0hasant/Liion_Cell_Simulator/docs/SCHEMATIC_REVIEW.md

# Schematic review (closed in v0.4)

The v0.3 checklist asked you to mark every item OK / CHANGE / ?. It was still empty when the hardware had to be finished, so the items were decided in v0.4. The decision for each ID (P-01 … F-02) is in `docs/CHANGES_v0.4.md`, section 2.

If you disagree with a decision, write the ID and what you want here and commit. `hardware/tools/design.py` holds the whole circuit, so most changes are one or two lines there.

| ID | Your comment |
|---|---|
| | |

What still has to be checked is no longer on paper but on the bench: `docs/BRINGUP.md`.

The part list with pin-to-net connections is `hardware/kicad/` (netlist) and `hardware/bom.csv`.
