0hasant/Liion_Cell_Simulator/docs/PROJECT_SYNC.md

# PROJECT_SYNC: shared context for all chats and sessions

Read this first in any new chat about the Li-ion cell test bench. It is where the hardware chat and the 3D/mechanical chat agree on what we are building and what the limits are.

- Repo: `0hasant/Liion_Cell_Simulator`.
- **Master copy: `docs/PROJECT_SYNC.md` in the repo.** The Claude Project "Li-ion cell characteristic tester" holds a mirror. Edit the repo file, commit, then update the Project copy with the same text.

Last updated: 2026-11-11 (repo state v0.4: hardware design complete, not yet built)

## 1. Goal

Build a single-cell Li-ion characterization bench so that, in the end, we can fit a **2RC equivalent-circuit model** of a cell (OCV, R0, R1/C1, R2/C2 versus SOC and temperature).

Order of work: (1) hardware and mechanics (**design done in v0.4**), (2) build and bring-up, (3) firmware + Python UI, (4) test procedures and model fitting.

This is part of the Solaris final-year project (see the DAB converter project).

- **Budget:** about 5,500 TL at 2026-11-10 prices (`hardware/bom.csv` + `hardware/bom_offboard.csv`). The old 1500 TL target cannot be met.
- **Workshop:** hand soldering, FDM printing (PETG/ASA, 220 × 220 mm bed), PCB milling on the Snapmaker Artisan / Artisan Premium.

## 2. What the bench does (requirements)

- **Cells:** 18650 and 21700, one at a time (DMEGC INR45E, generic 3.5 Ah 18650).
- **Discharge:** 0 to 10 A linear constant-current load, down to 2.0 V.
- **Charge:** from a 30 V bench PSU through an XL4016 module. Voltage set by MCU PWM below a 4.25 V hardware ceiling (module trimmer); **hardware current limit** 0–5.6 A set by MCU PWM.
  - Up to 5 A for the 21700 (INR45E).
  - The generic 3.5 Ah 18650 is limited to about 0.5C (≈1.75 A) until its datasheet is known.
- **Measurement:** bidirectional current on one 10 mΩ 2512 shunt with Kelvin taps, Kelvin cell voltage, both on one ADS1115. Four NTCs on the Blue Pill ADC. Fast current and voltage on the Blue Pill ADC for R0.
- **Temperature control:** cell held at about 10 to 45 °C in an insulated pocket, 2 × TEC1-12706, polarity relay for heat/cool.
- **Control:** STM32F103 Blue Pill, USB CDC to a Python UI.
- **Safety:** hardware OV / UV / OC / OT protection, latched, that drops a safety relay (removes power from all relay coils and the Peltier) without firmware. Power-up state is tripped.

## 3. Who owns what

| Area | Chat | Source of truth |
|---|---|---|
| Electronics (schematic, PCB, BOM, protection, parts choice) | Hardware chat | `hardware/` (generated by `hardware/tools/`) |
| Enclosure, thermal unit, cell pocket, printed parts | 3D / mechanical chat | `mechanical/` |
| Firmware, Python UI, test procedures, model fitting | Not started | `firmware/`, `ui/` |

Rule: a chat edits only its own area. If it needs something from the other area, it writes a request in section 7 instead of changing the other side.

## 4. Interface contract (the numbers both sides must respect)

### Hardware gives mechanics

| Item | Value | Source |
|---|---|---|
| PCB size | 180 × 130 mm, **single-sided** FR4 1.6 mm, milled in-house | `hardware/kicad/cell_test_bench.kicad_pcb` |
| Board model for fitting | `hardware/kicad/cell_test_bench.step` | `kicad-cli pcb export step` (see `mechanical/README.md`) |
| Mounting holes | 4 × M3 at (4, 4), (176, 68), (4, 126), (176, 126) mm from the PCB top-left corner. PCB on 8 mm standoffs. | `hardware/tools/pcbgen.py` |
| Connector placement | **Left:** PSU in J101, 12 V buck J102, charger J401, FB tap J402. **Top:** thermostat J104, fans J704/J706/J705, Peltier J702, Blue Pill USB (x ≈ 166). **Right:** NTCs J501–J504. **Bottom:** cell J205 (x 40), load resistor J301 (x 84), Q301 (x 108–119), Kelvin J206 (x 130). | `pcbgen.py` FIXED table |
| Load MOSFET | IRFP260N (TO-247), Q301 body centre at PCB x = 113.45, tab 0.6 mm inside the bottom edge, facing out | `pcbgen.py` |
| Plug-in modules | Blue Pill (USB end at top edge), ADS1115 (body over PCB x 152–169, y 68–96) | Dwgs.User layer |
| Heat sources | Q301 + 0.1 Ω 50 W resistor on the load cooler (up to about 40 W), XL4016 modules, 7805 (small) | |
| Thermostat | KSD9700 60 °C NC on the load cooler, wired to J104 (in series with the safety relay coil) | Power sheet |
| Fans | Two 12 V cooler fans switched together on one PWM (PA8): load cooler and Peltier hot-side cooler. One 12 V 30 mm pocket mixing fan, always on. | Thermal sheet |
| Peltier | Two TEC1-12706 in series on J702 (2 wires, about 3 A). No driver module in the thermal unit. | Thermal sheet |
| NTCs (4, on PA2–PA5) | Cell surface (taped to the cell), pocket air (lid port), load cooler, Peltier hot side | Measurement sheet |

### Mechanics gives hardware

| Item | Value |
|---|---|
| Electronics box | 214 × 214 × 89 mm outer (86 mm base + 3 mm lid) |
| Load cooler | 80 × 80 × 54 mm CPU cooler on its side, base flush with the PCB bottom edge, centred on Q301, fan facing the front wall |
| Thermal unit | 130 × 130 × about 155 mm outer (base 72.8 mm + 8 mm feet, pocket body 56 mm, lid 18 mm) |
| Cell pocket | 100 × 50 × 6 mm aluminium cold plate is the pocket floor. Saddles T6 (18650) / T7 (21700). Contact plates 22 × 22 × 1.5 mm copper with a spring probe for Kelvin sense. |
| Cable links between units | Grommet 1 (right wall, y 95): cell power 2 × 1.5 mm² + Kelvin pair. Grommet 2 (right wall, y 175): Peltier 2 × 0.75 mm², two fan pairs, three NTC pairs. |

## 5. Hard constraints (do not break without agreeing)

1. One cell at a time, 18650 or 21700, swapped by changing the printed saddle.
2. Pocket temperature range about 10 to 45 °C. Printed parts near the cell and the load cooler must be PETG or ASA, not PLA.
3. Every printed part fits a 220 × 220 mm bed (`mechanical/check.py` checks it).
4. Max currents:
   - Discharge: 10 A (trip about 11.6 A).
   - Charge: 5 A (hardware limit 5.6 A, trip about 6.2 A); generic 18650 about 1.75 A.
   - Wiring, contacts and the shunt path must carry this. No wire jumpers in the cell loop.
5. Cell voltage limits enforced in hardware: OV about 4.33 V, UV about 1.96 V. OT trip about 61 °C on the heatsink or cell NTC. Charger ceiling 4.25 V.
6. Cell terminals need four-wire (Kelvin) contact.
7. Hand-solderable parts: through-hole, plus R201 (2512) and U301 (SOIC-8) on the copper side.
8. PCB design rules for milling: 0.5 mm track, 0.4 mm clearance, copper ≥ 1 mm from the edge, annular ring ≥ 0.4 mm.
9. Every part must be buyable in Türkiye (`hardware/tools/sourcing.py` holds shop, price, stock and link).
10. The KiCad files are generated. Once someone edits them by hand in KiCad, those files become the source of truth: don't re-run the generators after that.

## 6. Known limits and risks (carry these forward)

- **Not built yet.** All circuit numbers are calculated, not measured. Follow `docs/BRINGUP.md`.
- **Wire jumpers:** a single copper layer needs several wire jumpers on the component side (`hardware/fab/jumpers.csv`).
- **Milled copper is thin:** reinforce the cell loop and PGND strip with 1.5 mm² wire (`docs/CNC_MILLING.md`).
- **Voltage trips are ground-referenced:** at 5 A charge OV acts near 4.28 V, at 10 A discharge UV near 2.06 V.
- **UV trips with no cell** and blocks arming without a cell (intended).
- **ADS1115 divider** draws 0.2 mA from a cell left in the pocket with the bench off.
- **Check before soldering:** ADS1115 module pin order, HK14FD relay pinout, SRD relay contact pins, real cooler base flatness.
- **Load loop stability** depends on layout: scope the current step at bring-up (C304).
- **3D envelopes:** cooler, XL4016 and resistor shapes are envelopes. Measure real parts and update `mechanical/enclosure.py`.
- **Lowest cell temperature:** depends on the hot-side cooler; measure before relying on below-ambient tests.
- **Prices and stock:** checked on one day (2026-11-10). A few generic items are estimates.

## 7. Open interface items (requests between chats)

Add one line per item: `date | from -> to | request | status`.

- 2026-10-28 | sync review -> hardware + mechanics | Peltier driver location. | **Superseded 2026-11-10:** BTS7960 removed in v0.4. Peltiers driven from the main board (K3 polarity relay + IRLZ44N), two wires to the thermal unit.
- 2026-11-10 | hardware -> mechanics | v0.4 board: heatsinks are 80 × 80 × 54 mm CPU coolers, no MP1584, no BTS7960, connectors moved (section 4). | **Done 2026-11-11** in `mechanical/enclosure.py` v0.4.

## 8. Change protocol

1. Before changing any number in section 4 or 5, edit this file in the same commit and add a line to the changelog.
2. If hardware moves a connector, heatsink position, or mounting hole, the PCB STEP must be regenerated and the mechanical side told via section 7.
3. If mechanics changes box size, standoff height, or cable path, the hardware side is told via section 7.
4. Start of every chat: read this file, then `README.md` (and `mechanical/README.md` for 3D work).
   - PCB work: `docs/LAYOUT_REVIEW.md` (checklist), `docs/CNC_MILLING.md`.
   - Schematic work: `docs/SCHEMATIC_GUIDE.md`, `docs/CHANGES_v0.4.md`.
5. After editing this file in the repo, copy the same text to the Claude Project (`claude/PROJECT_SYNC.md`).

## 9. Changelog

- 2026-10-28: file created from repo state v0.2 when hardware and 3D design were split into separate chats.
- 2026-10-28: review fixes; layout moved to Quilter; BTS7960 location decided (option a).
- 2026-10-29 (v0.3.2): layout paused for a schematic review. Added `docs/SCHEMATIC_GUIDE.md` and `docs/SCHEMATIC_REVIEW.md`.
- 2026-11-11 (v0.4): hardware design finished.
  - Schematic v0.4: parts replaced by ones in stock in Türkiye; review items closed (`docs/CHANGES_v0.4.md`). MCP4725 ×2, second ADS1115, BTS7960, MP1584 removed; hardware charge-current limit, fault latch and safety relay added; PGND/GND split.
  - Single-sided PCB routed in-house (`hardware/tools/route2.py`), because Quilter can't make single-sided boards. CNC files in `hardware/fab/`.
  - Priced BOM with Turkish shops.
  - Enclosure v0.4: CPU coolers, cooler cradle, taller thermal base, cold-plate clamp, grommets moved.
  - New docs: `CHANGES_v0.4.md`, `BRINGUP.md`, `CNC_MILLING.md`.
