0hasant/Liion_Cell_Simulator/hardware/fab/drill_summary.csv

Hole mm | Count | Use
0.8 | 266 | IC, header, small diode, transistor
1.0 | 212 | resistors, caps, wire jumpers
1.3 | 25 | terminals, TO-220/247, relays
1.5 | 47 | relay power pins, TO-247
1.8 | 6 | terminal blocks
2.0 | 4 | large pins
3.2 | 4 | M3 mounting holes
