0hasant/Liion_Cell_Simulator/hardware/fab/jumpers.csv

Wire | Footprint | Net | From pad | x1 mm | y1 mm | To pad | x2 mm | y2 mm | Length mm | Wire type
W1 | W1 | +12V | 1 | 29.4 | 18.2 | 2 | 29.4 | 44.6 | 26.4 | 0.75 mm2 stranded (power)
W2 | W2 | +12V | 1 | 33.5 | 17.4 | 2 | 55.4 | 7.0 | 24.2 | 0.75 mm2 stranded (power)
W3 | W3 | +12V | 1 | 64.5 | 9.5 | 2 | 82.2 | 37.1 | 32.8 | 0.75 mm2 stranded (power)
W4 | W4 | +12V | 1 | 70.0 | 6.5 | 2 | 77.4 | 7.0 | 7.4 | 0.75 mm2 stranded (power)
W5 | W5 | +12V | 1 | 86.2 | 37.4 | 2 | 85.5 | 53.2 | 15.8 | 0.75 mm2 stranded (power)
W6a | W6 | +12VA | 1 | 103.0 | 72.8 | 2 | 98.6 | 63.7 | 10.1 | 0.6 mm solid, insulated
W6b | W6 | +12VA | 2 | 98.6 | 63.7 | 3 | 85.3 | 63.6 | 13.3 | 0.6 mm solid, insulated
W6c | W6 | +12VA | 1 | 103.0 | 72.8 | 4 | 118.3 | 89.8 | 22.9 | 0.6 mm solid, insulated
W7 | W7 | +12V_SW | 1 | 62.8 | 48.0 | 2 | 78.2 | 26.3 | 26.6 | 0.75 mm2 stranded (power)
W8 | W8 | +12V_SW | 1 | 68.2 | 18.8 | 2 | 54.8 | 18.8 | 13.4 | 0.75 mm2 stranded (power)
W9 | W9 | +12V_SW | 1 | 78.7 | 22.5 | 2 | 70.6 | 18.2 | 9.2 | 0.75 mm2 stranded (power)
W10 | W10 | +3V3 | 1 | 135.3 | 67.1 | 2 | 124.8 | 68.3 | 10.6 | 0.6 mm solid, insulated
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
