0hasant/Liion_Cell_Simulator/docs/pcb_v0.4_copper_mirrored.png

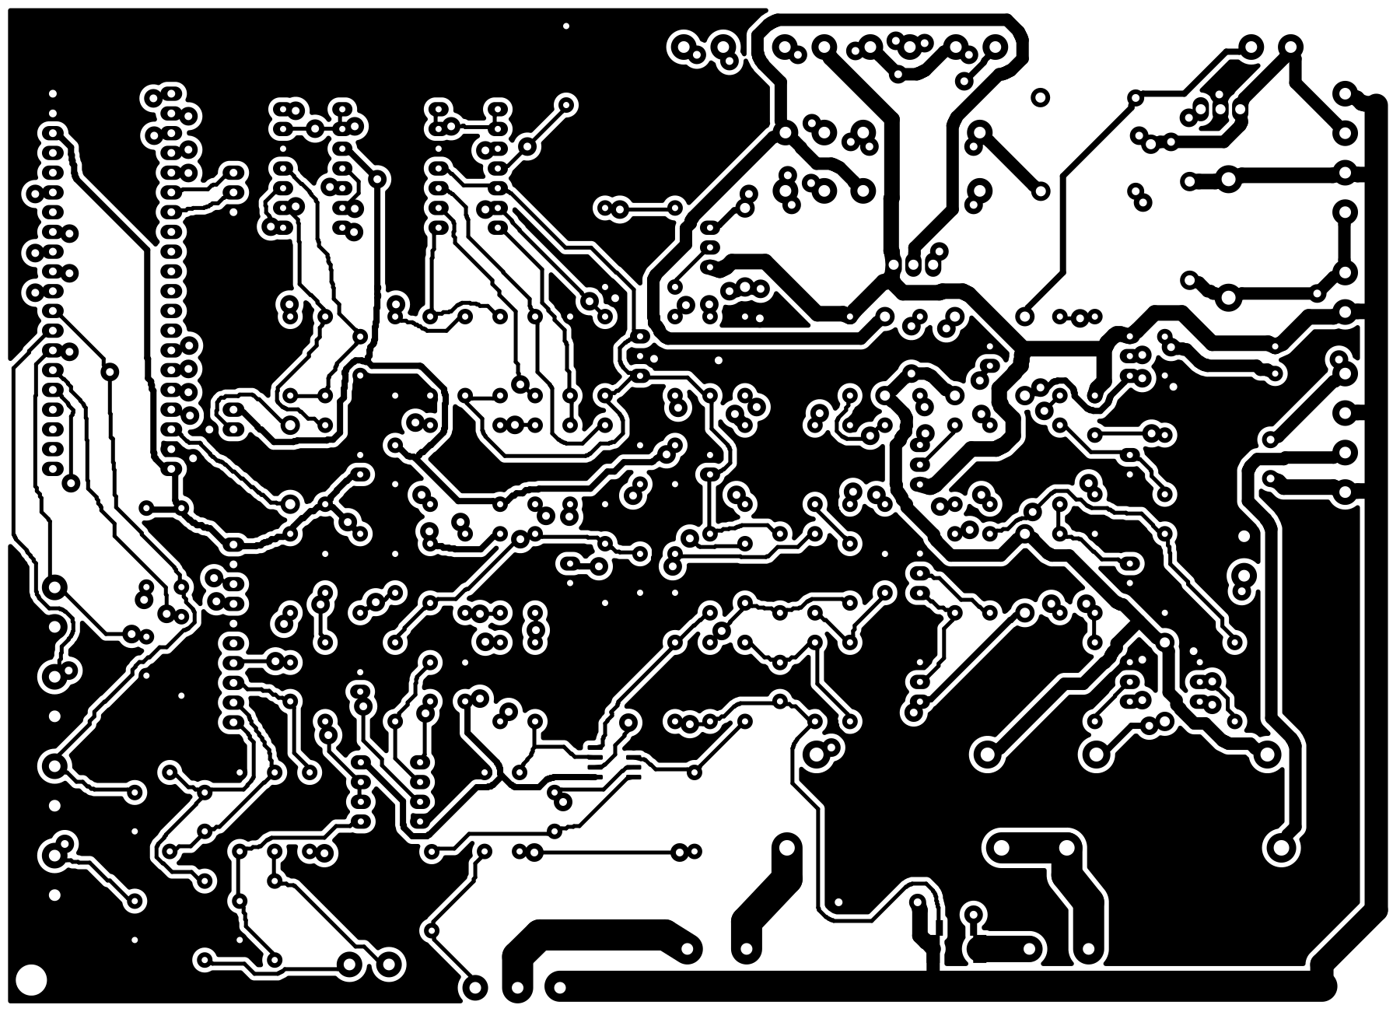
docs/pcb_v0.4_copper_mirrored.png
