0hasant/Liion_Cell_Simulator/docs/pcb_v0.4_layout.png

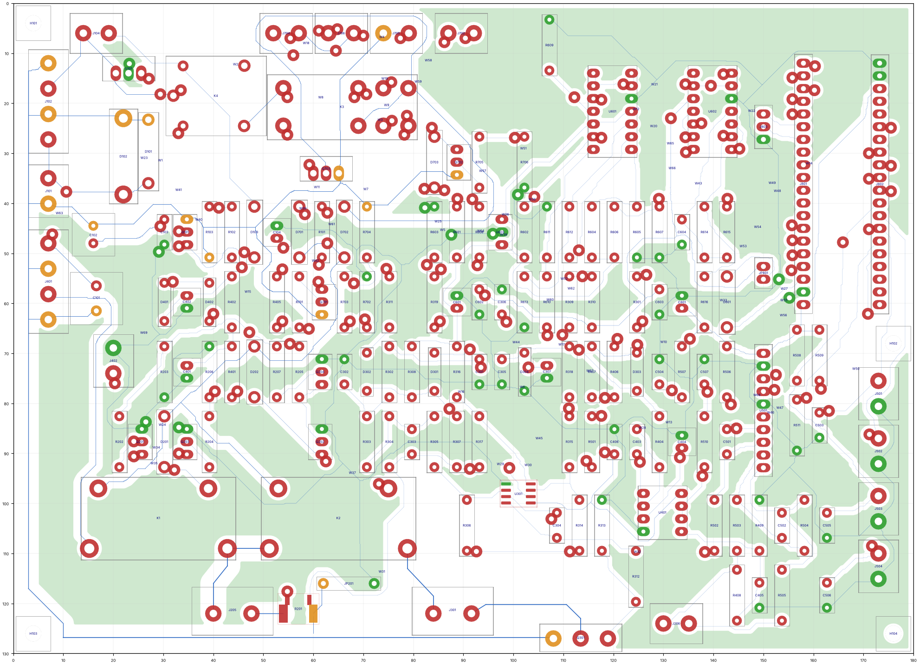
docs/pcb_v0.4_layout.png
