0hasant/Liion_Cell_Simulator/mechanical/renders/electronics_box.png

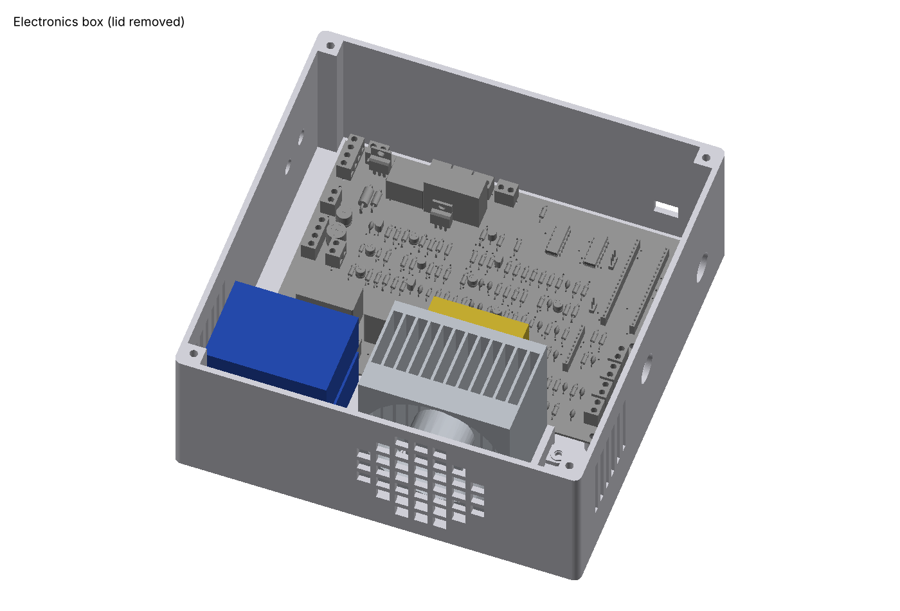
mechanical/renders/electronics_box.png
