0hasant/Liion_Cell_Simulator/mechanical/renders/thermal_pocket_detail.png

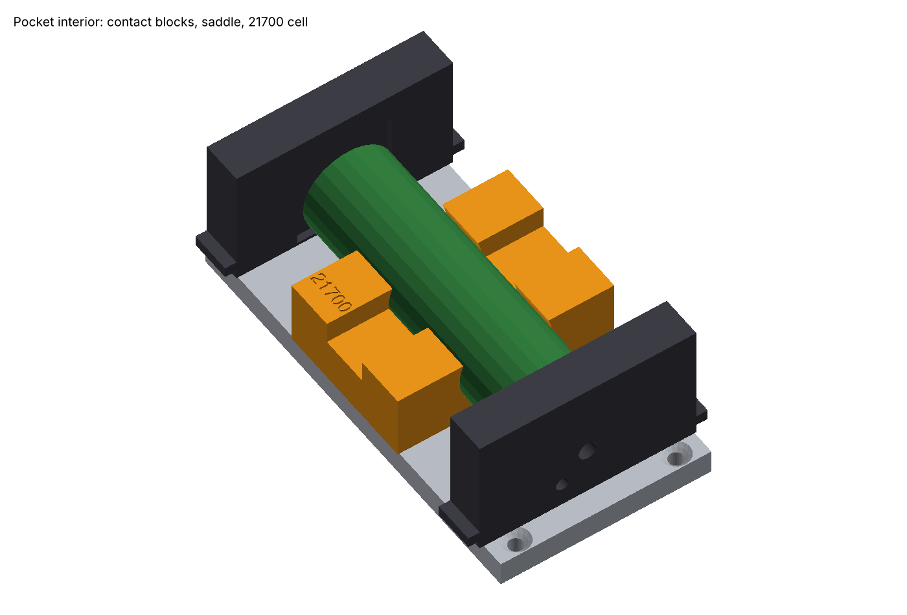
mechanical/renders/thermal_pocket_detail.png
