0hasant/Liion_Cell_Simulator/mechanical/renders/thermal_unit.png

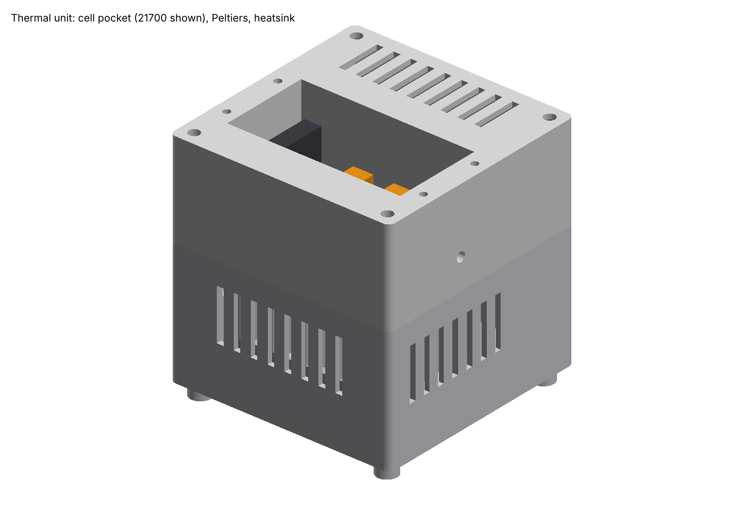
mechanical/renders/thermal_unit.png
