0hasant/Liion_Cell_Simulator/hardware/bom.csv

Qty | References | Value | Footprint | Buy | Shop | Unit TL (VAT incl.) | Line TL | Stock 2026-11-10 | Link | Note
1 | C101 | 100uF 50V | CP_Radial_D10.0mm_P5.00mm | electrolytic 100 uF 50 V, D10 P5 | Direnc.net | 4.00 | 4.00 | generic, price estimated
1 | C102 | 220uF 25V | CP_Radial_D8.0mm_P3.50mm | electrolytic 220 uF 25 V, D8 P3.5 | Direnc.net | 3.00 | 3.00 | generic, price estimated
13 | C103 C303 C306 C403 C406 C501 C502 C503 C504 C505 C506 C602 C603 | 100nF | C_Disc_D5.0mm_W2.5mm_P5.00mm | ceramic capacitor, radial, 5 mm pitch, 50 V | Direnc.net | 0.98 | 12.74 | in stock (100 nF checked) | https://www.direnc.net/100nf-63v-seramik | 1 nF / 10 nF / 1 uF: same series, price similar
7 | C104 C307 C401 C402 C404 C601 C801 | 10uF 25V | CP_Radial_D5.0mm_P2.50mm | electrolytic 10 uF 25 V (or 50 V), D5 P2.5 | Direnc.net | 1.50 | 10.50 | generic, price estimated
2 | C301 C302 | 1uF | C_Disc_D5.0mm_W2.5mm_P5.00mm | ceramic capacitor, radial, 5 mm pitch, 50 V | Direnc.net | 0.98 | 1.96 | in stock (100 nF checked) | https://www.direnc.net/100nf-63v-seramik | 1 nF / 10 nF / 1 uF: same series, price similar
1 | C304 | 1nF | C_Disc_D5.0mm_W2.5mm_P5.00mm | ceramic capacitor, radial, 5 mm pitch, 50 V | Direnc.net | 0.98 | 0.98 | in stock (100 nF checked) | https://www.direnc.net/100nf-63v-seramik | 1 nF / 10 nF / 1 uF: same series, price similar
4 | C305 C405 C507 C604 | 10nF | C_Disc_D5.0mm_W2.5mm_P5.00mm | ceramic capacitor, radial, 5 mm pitch, 50 V | Direnc.net | 0.98 | 3.92 | in stock (100 nF checked) | https://www.direnc.net/100nf-63v-seramik | 1 nF / 10 nF / 1 uF: same series, price similar
1 | D101 | P6KE39CA (TVS) | D_DO-15_P12.70mm_Horizontal | P6KE39CA TVS 600 W DO-15 | Direnc.net | 12.79 | 12.79 | in stock | https://www.direnc.net/p6ke39ca-do-15-371v-600w-tvs-diyot
1 | D102 | 1N5408 | D_DO-201AD_P15.24mm_Horizontal | 1N5408 3 A DO-201 | Direnc.net | 2.72 | 2.72 | in stock | https://www.direnc.net/1n5408-rectifiers-1000v-3a--mic
7 | D103 D201 D202 D701 D702 D703 D801 | 1N5819 | D_DO-41_SOD81_P10.16mm_Horizontal | 1N5819 Schottky 1 A 40 V DO-41 | Direnc.net | 1.57 | 10.99 | in stock | https://www.direnc.net/1n5819-1a-40v-schottky-rectifier-mic | 1N4007 was sold out, 1N5819 does the same job here
2 | D301 D302 | 1N4148 | D_DO-35_SOD27_P7.62mm_Horizontal | 1N4148 DO-35 | Robotistan | 0.79 | 1.58 | in stock | https://www.robotistan.com/1n4148-100v-450ma-aksiyel-tipli-hizli-diyot | sold out at Direnc
4 | D303 D304 D401 D402 | BAT85 | D_DO-35_SOD27_P7.62mm_Horizontal | BAT85 Schottky DO-35 | Direnc.net | 2.03 | 8.12 | in stock | https://www.direnc.net/bat85-schottky-diodes-rectifiers-schottky-30v-200ma
2 | J101 J702 | PSU in 30V (+, -) via inline 5A fuse | TerminalBlock_bornier-2_P5.08mm | 2-pin 5.08 mm screw terminal ("1 No") | Direnc.net | 4.84 | 9.68 | in stock | https://www.direnc.net/1-numara-2li-klemens
2 | J102 J401 | 12V buck XL4016: IN+ IN- OUT+ OUT- | TerminalBlock_bornier-4_P5.08mm | 4-pin 5.08 mm screw terminal (two 2-pin blocks slid together) | Direnc.net | 9.68 | 19.36 | in stock | https://www.direnc.net/1-numara-2li-klemens
10 | J104 J206 J402 J501 J502 J503 J504 J704 J706 J705 | Thermostat 60C NC (on load heatsink) | TerminalBlock_bornier-2_P5.08mm | 2-pin 5.08 mm screw terminal ("0 No") | Direnc.net | 3.45 | 34.50 | in stock | https://www.direnc.net/0-numara-2li-klemens-1 | sensor, fan, thermostat and FB wires
2 | J205 J301 | Cell power to pocket (+, -) via inline 15A fuse | PhoenixContact_GMSTBVA_2,5_2-G-7,62_1x02_P7.62mm_Vertical | 2-pin 7.62 mm pluggable terminal, header 180 deg + plug | Direnc.net | 13.21 | 26.42 | in stock | https://www.direnc.net/2-pin-762mm-90-gecmeli-takim-klemens-12424 | plug: https://www.direnc.net/2-pin-762mm-90-gecmeli-takim-klemens
2 | J801 J802 | Blue Pill header A: B12 B13 B14 B15 A8 A9 A10 A11 A12 A15 B3 B4 B5 B6 B7 B8 B9 5V GND 3V3 | PinSocket_1x20_P2.54mm_Vertical | 1x40 precision (machined) female header 2.54 mm, cut to 1x20 | Direnc.net | 21.17 | 42.34 | in stock | https://www.direnc.net/1x40-precision-disi-header | the plain 1x40 female header (6.05 TL) was sold out; cutting a machined strip costs one pin
1 | J803 | Debug UART: TX RX GND | PinHeader_1x03_P2.54mm_Vertical | 1x40 male pin header 2.54 mm (cut) | Direnc.net | 5.00 | 5.00 | generic, price estimated
1 | JP201 | GND-PGND link (wire) | WireLink_P10.16mm | wire link (resistor leg or 0.8 mm copper wire) | - | 0.00 | 0.00 | -
1 | JP801 | Board 5V to Blue Pill (normally open) | PinHeader_1x02_P2.54mm_Vertical | 1x40 male pin header 2.54 mm (cut) | Direnc.net | 5.00 | 5.00 | generic, price estimated
2 | K1 K2 | ALFG2PF121 (charge) | Relay_SPST_Panasonic_ALFG_FormA_CircularHoles | Panasonic ALFG2PF121, 12 V, 33 A | Ozdisan | 148.90 | 297.80 | 28609 in stock | https://ozdisan.com/elektromekanik-komponentler/roleler-ve-role-soketleri/genel-tip-roleler/ALFG2PF121/462930 | USD 2.64 + VAT
1 | K3 | HK14FD-DC12V-SHG (DPDT, polarity) | Relay_DPDT_Finder_40.52 | Huike HK14FD-DC12V-SHG, DPDT 5 A, 12 V ("4052" type) | Direnc.net | 72.59 | 72.59 | in stock | https://www.direnc.net/12v-cift-kontak-huike-4052-12v-10a | alternative: Tianbo TRA3-L-12VDC-S-2Z (116 TL)
1 | K4 | SRD-12VDC-SL-C (safety) | Relay_SPDT_SANYOU_SRD_Series_Form_C | Songle SRD-12VDC-SL-C, 10 A | Robotistan | 20.68 | 20.68 | in stock | https://www.robotistan.com/12v-10a-tek-kontak-role-srd12vdcslc
5 | Q101 Q201 Q202 Q701 Q702 | BC337 | TO-92_Inline_Wide | BC337 NPN TO-92 | Direnc.net | 1.21 | 6.05 | in stock | https://www.direnc.net/bc337-transistor-bjt-npn-to-92
2 | Q203 Q204 | BC547 | TO-92_Inline_Wide | BC547 NPN TO-92 | Direnc.net | 1.28 | 2.56 | in stock | https://www.direnc.net/bc547-transistor-bjt-npn-to-92
1 | Q301 | IRFP260N | TO-247-3_Vertical | IRFP260NPBF TO-247 | Ozdisan | 43.43 | 43.43 | 4451 in stock | https://www.ozdisan.com/en/p/discrete-mosfets-435/infineon-irfp260npbf-3517 | USD 0.77 + VAT; Direnc lists IRFP260M at 69.87 TL (sold out on the check date)
1 | Q703 | IRLZ44N | TO-220-3_Vertical | IRLZ44NPBF TO-220 (VBsemi) | Robotistan | 24.46 | 24.46 | in stock | https://www.robotistan.com/vbsemi-elec-irlz44npbf-vb | TO-220 was sold out at Direnc
2 | R101 R102 | 2.2k | R_Axial_DIN0207_L6.3mm_D2.5mm_P10.16mm_Horizontal | 1/4 W 1 % metal film resistor (E24 value) | Direnc.net | 0.67 | 1.34 | in stock (series) | https://www.direnc.net/14w-metal-film-direnc | check each value in the cart; all values used are E24
1 | R103 | 4.7k | R_Axial_DIN0207_L6.3mm_D2.5mm_P10.16mm_Horizontal | 1/4 W 1 % metal film resistor (E24 value) | Direnc.net | 0.67 | 0.67 | in stock (series) | https://www.direnc.net/14w-metal-film-direnc | check each value in the cart; all values used are E24
1 | R201 | 10mR 1% 2.5W 2512 | R_Shunt_2512_Kelvin | Isabellenhuette CMS 10 mOhm 1 % 2.5 W, 2512 | Direnc.net | 39.63 | 39.63 | in stock | https://www.direnc.net/10mr-2515-sont-direnc | listed as "10mR 2515"; datasheet says size 2512
8 | R202 R205 R304 R314 R317 R318 R601 R701 | 1k | R_Axial_DIN0207_L6.3mm_D2.5mm_P10.16mm_Horizontal | 1/4 W 1 % metal film resistor (E24 value) | Direnc.net | 0.67 | 5.36 | in stock (series) | https://www.direnc.net/14w-metal-film-direnc | check each value in the cart; all values used are E24
29 | R203 R204 R206 R207 R301 R302 R305 R306 R307 R310 R313 R406 R408 R503 R504 R506 R507 R508 R509 R510 R511 R602 R603 R605 R615 R616 R702 R704 R706 | 10k | R_Axial_DIN0207_L6.3mm_D2.5mm_P10.16mm_Horizontal | 1/4 W 1 % metal film resistor (E24 value) | Direnc.net | 0.67 | 19.43 | in stock (series) | https://www.direnc.net/14w-metal-film-direnc | check each value in the cart; all values used are E24
1 | R303 | 6.8k | R_Axial_DIN0207_L6.3mm_D2.5mm_P10.16mm_Horizontal | 1/4 W 1 % metal film resistor (E24 value) | Direnc.net | 0.67 | 0.67 | in stock (series) | https://www.direnc.net/14w-metal-film-direnc | check each value in the cart; all values used are E24
1 | R308 | 10M | R_Axial_DIN0207_L6.3mm_D2.5mm_P10.16mm_Horizontal | 1/4 W 1 % metal film resistor (E24 value) | Direnc.net | 0.67 | 0.67 | in stock (series) | https://www.direnc.net/14w-metal-film-direnc | check each value in the cart; all values used are E24
3 | R309 R613 R614 | 100k | R_Axial_DIN0207_L6.3mm_D2.5mm_P10.16mm_Horizontal | 1/4 W 1 % metal film resistor (E24 value) | Direnc.net | 0.67 | 2.01 | in stock (series) | https://www.direnc.net/14w-metal-film-direnc | check each value in the cart; all values used are E24
1 | R311 | 150k | R_Axial_DIN0207_L6.3mm_D2.5mm_P10.16mm_Horizontal | 1/4 W 1 % metal film resistor (E24 value) | Direnc.net | 0.67 | 0.67 | in stock (series) | https://www.direnc.net/14w-metal-film-direnc | check each value in the cart; all values used are E24
6 | R312 R319 R501 R502 R505 R703 | 100R | R_Axial_DIN0207_L6.3mm_D2.5mm_P10.16mm_Horizontal | 1/4 W 1 % metal film resistor (E24 value) | Direnc.net | 0.67 | 4.02 | in stock (series) | https://www.direnc.net/14w-metal-film-direnc | check each value in the cart; all values used are E24
1 | R315 | 12k | R_Axial_DIN0207_L6.3mm_D2.5mm_P10.16mm_Horizontal | 1/4 W 1 % metal film resistor (E24 value) | Direnc.net | 0.67 | 0.67 | in stock (series) | https://www.direnc.net/14w-metal-film-direnc | check each value in the cart; all values used are E24
1 | R316 | 18k | R_Axial_DIN0207_L6.3mm_D2.5mm_P10.16mm_Horizontal | 1/4 W 1 % metal film resistor (E24 value) | Direnc.net | 0.67 | 0.67 | in stock (series) | https://www.direnc.net/14w-metal-film-direnc | check each value in the cart; all values used are E24
2 | R401 R402 | 560R | R_Axial_DIN0207_L6.3mm_D2.5mm_P10.16mm_Horizontal | 1/4 W 1 % metal film resistor (E24 value) | Direnc.net | 0.67 | 1.34 | in stock (series) | https://www.direnc.net/14w-metal-film-direnc | check each value in the cart; all values used are E24
2 | R404 R609 | 15k | R_Axial_DIN0207_L6.3mm_D2.5mm_P10.16mm_Horizontal | 1/4 W 1 % metal film resistor (E24 value) | Direnc.net | 0.67 | 1.34 | in stock (series) | https://www.direnc.net/14w-metal-film-direnc | check each value in the cart; all values used are E24
1 | R405 | 3.3k | R_Axial_DIN0207_L6.3mm_D2.5mm_P10.16mm_Horizontal | 1/4 W 1 % metal film resistor (E24 value) | Direnc.net | 0.67 | 0.67 | in stock (series) | https://www.direnc.net/14w-metal-film-direnc | check each value in the cart; all values used are E24
1 | R407 | 22k | R_Axial_DIN0207_L6.3mm_D2.5mm_P10.16mm_Horizontal | 1/4 W 1 % metal film resistor (E24 value) | Direnc.net | 0.67 | 0.67 | in stock (series) | https://www.direnc.net/14w-metal-film-direnc | check each value in the cart; all values used are E24
1 | R409 | 1M | R_Axial_DIN0207_L6.3mm_D2.5mm_P10.16mm_Horizontal | 1/4 W 1 % metal film resistor (E24 value) | Direnc.net | 0.67 | 0.67 | in stock (series) | https://www.direnc.net/14w-metal-film-direnc | check each value in the cart; all values used are E24
2 | R604 R611 | 16k | R_Axial_DIN0207_L6.3mm_D2.5mm_P10.16mm_Horizontal | 1/4 W 1 % metal film resistor (E24 value) | Direnc.net | 0.67 | 1.34 | in stock (series) | https://www.direnc.net/14w-metal-film-direnc | check each value in the cart; all values used are E24
1 | R606 | 27k | R_Axial_DIN0207_L6.3mm_D2.5mm_P10.16mm_Horizontal | 1/4 W 1 % metal film resistor (E24 value) | Direnc.net | 0.67 | 0.67 | in stock (series) | https://www.direnc.net/14w-metal-film-direnc | check each value in the cart; all values used are E24
2 | R607 R610 | 9.1k | R_Axial_DIN0207_L6.3mm_D2.5mm_P10.16mm_Horizontal | 1/4 W 1 % metal film resistor (E24 value) | Direnc.net | 0.67 | 1.34 | in stock (series) | https://www.direnc.net/14w-metal-film-direnc | check each value in the cart; all values used are E24
1 | R608 | 11k | R_Axial_DIN0207_L6.3mm_D2.5mm_P10.16mm_Horizontal | 1/4 W 1 % metal film resistor (E24 value) | Direnc.net | 0.67 | 0.67 | in stock (series) | https://www.direnc.net/14w-metal-film-direnc | check each value in the cart; all values used are E24
1 | R612 | 24k | R_Axial_DIN0207_L6.3mm_D2.5mm_P10.16mm_Horizontal | 1/4 W 1 % metal film resistor (E24 value) | Direnc.net | 0.67 | 0.67 | in stock (series) | https://www.direnc.net/14w-metal-film-direnc | check each value in the cart; all values used are E24
1 | R705 | 470R | R_Axial_DIN0207_L6.3mm_D2.5mm_P10.16mm_Horizontal | 1/4 W 1 % metal film resistor (E24 value) | Direnc.net | 0.67 | 0.67 | in stock (series) | https://www.direnc.net/14w-metal-film-direnc | check each value in the cart; all values used are E24
1 | U101 | L7805CV | TO-220-3_Vertical | L7805CV TO-220 | Direnc.net | 8.72 | 8.72 | in stock | https://www.direnc.net/l7805cv-5v-15a-lineer-voltaj-regulator-to220
1 | U301 | OPA2171AIDR | SOIC-8_3.9x4.9mm_P1.27mm | OPA2171AIDR SOIC-8 | Direnc.net | 93.76 | 93.76 | in stock | https://www.direnc.net/opa2171aidr-smd-10396 | replaces OPA2188 (no stock in Turkiye)
1 | U401 | LM358P | DIP-8_W7.62mm | LM358P DIP-8 | Direnc.net | 4.23 | 4.23 | in stock | https://www.direnc.net/arama?q=LM358P
1 | U501 | ADS1115 module (ADDR=GND): VDD GND SCL SDA ADDR ALRT A0 A1 A2 A3 | PinSocket_1x10_P2.54mm_Vertical | ADS1115 16-bit I2C module + socket strip | Direnc.net | 145.18 | 145.18 | in stock | https://www.direnc.net/ads1115-16-bit-i2c-4-kanal-modul | pin order must be VDD GND SCL SDA ADDR ALRT A0 A1 A2 A3
2 | U601 U602 | LM339N | DIP-14_W7.62mm | LM339N DIP-14 | Direnc.net | 6.05 | 12.10 | in stock | https://www.direnc.net/lm339n-pdip-14-dip-komparator-entegresi
1 | U603 | TL431 (TO-92) | TO-92_Inline_Wide | TL431G-T92-B, TO-92 | Direnc.net | 3.51 | 3.51 | in stock | https://www.direnc.net/tl431g-t92-b-to92-voltaj-referans-entegresi
 |  |  |  | PCB parts total |  |  | 1036.53
