0hasant/Liion_Cell_Simulator/mechanical/step/cell_test_bench_assembly.step

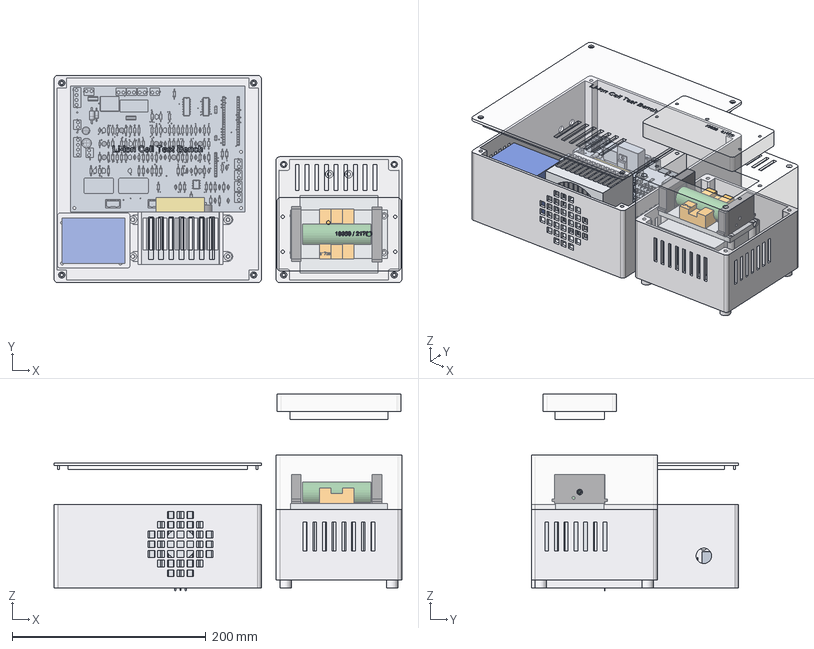
[picture p6: CAD file, 2026-11-10]
mechanical/step/cell_test_bench_assembly.step
359.0 x 214.0 x 203.0 mm
E1_ebox_base
E2_ebox_lid
PCB
E4_cooler_cradle
load_cooler_80x80x54
series_R_0R1_50W
KSD9700_60C
E3_module_plate
XL4016_charger
XL4016_12V
T1_thermal_base
hot_side_cooler_80x80x54
TEC1_12706_1
TEC1_12706_2
cold_plate_alu
T2_pocket_body
T3_pocket_lid
thermal_pad
T4_contact_block_fixed
T5_contact_block_slider
T7_saddle_21700
cell_21700
