0hasant/Liion_Cell_Simulator/hardware/kicad/cell_test_bench.step

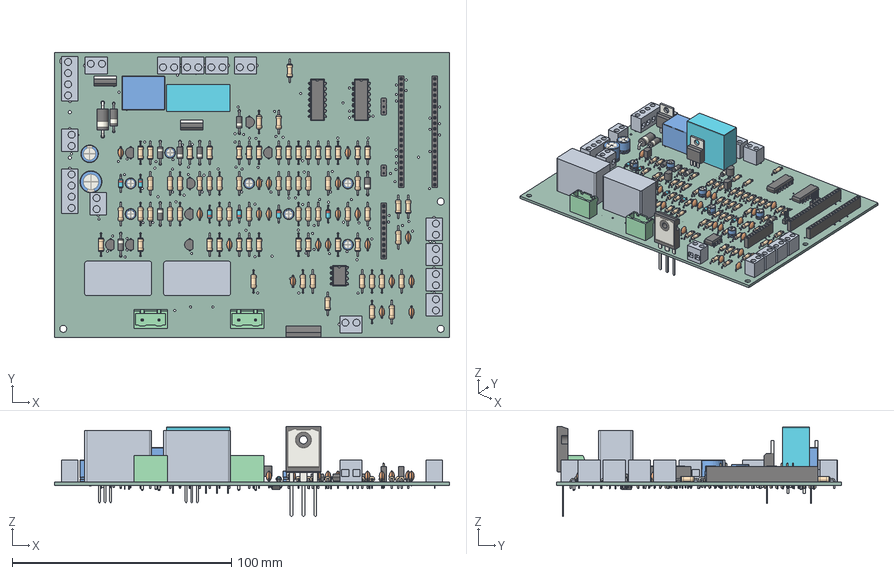
[picture p7: CAD file, 2026-11-10]
hardware/kicad/cell_test_bench.step
180.0 x 130.0 x 41.1 mm
TO-92_Inline_Wide x 8
R_Axial_DIN0207_L63mm_D25mm_P1016mm_Horizontal x 69
D_DO-201AD_P15.24mm_Horizontal
C_Disc_D50mm_W25mm_P500mm x 20
Relay_SPDT_SANYOU_SRD_Series_Form_C
D_DO-41_SOD81_P10.16mm_Horizontal x 7
TO-220-3_Vertical x 2
D_DO-35_SOD27_P7.62mm_Horizontal x 6
PinSocket_1x20_P254mm_Vertical x 2
PinHeader_1x03_P254mm_Vertical
D_DO-15_P12.70mm_Horizontal
Relay_DPDT_Finder_40.52
DIP-14_W7.62mm x 2
CP_Radial_D80mm_P350mm
TO-247-3_Vertical
GMSTBVA_01x02_G_7_62mm x 2
CP_Radial_D50mm_P250mm x 7
PinHeader_1x02_P254mm_Vertical
PinSocket_1x10_P254mm_Vertical
CP_Radial_D100mm_P500mm
DIP-8_W7.62mm
SOIC_8_39x49mm_P127mm
cell_test_bench PCB
