0hasant/Liion_Cell_Simulator/mechanical/stl/T3_pocket_lid.stl

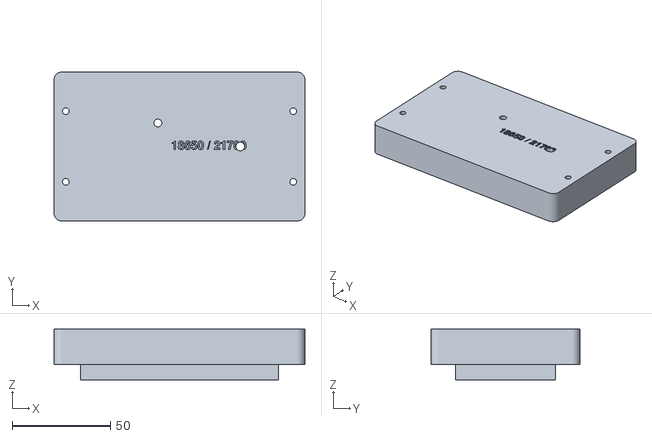
[picture p8: CAD file, 2026-11-10]
mechanical/stl/T3_pocket_lid.stl
128.0 x 76.0 x 26.0
