0hasant/Liion_Cell_Simulator/mechanical/stl/T1_thermal_base.stl

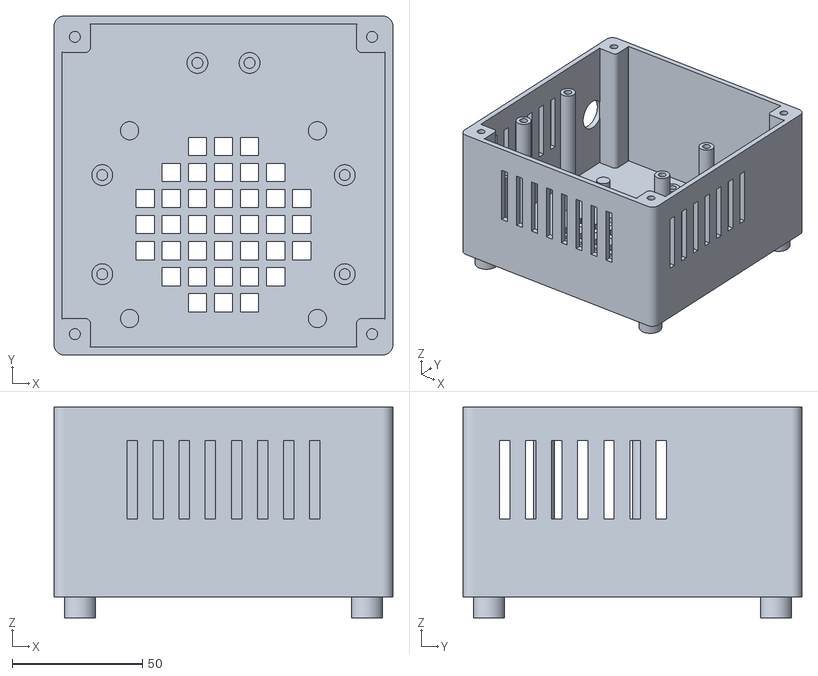
[picture p9: CAD file, 2026-11-10]
mechanical/stl/T1_thermal_base.stl
130.0 x 130.0 x 80.8
