0hasant/Liion_Cell_Simulator/mechanical/stl/E2_ebox_lid.stl

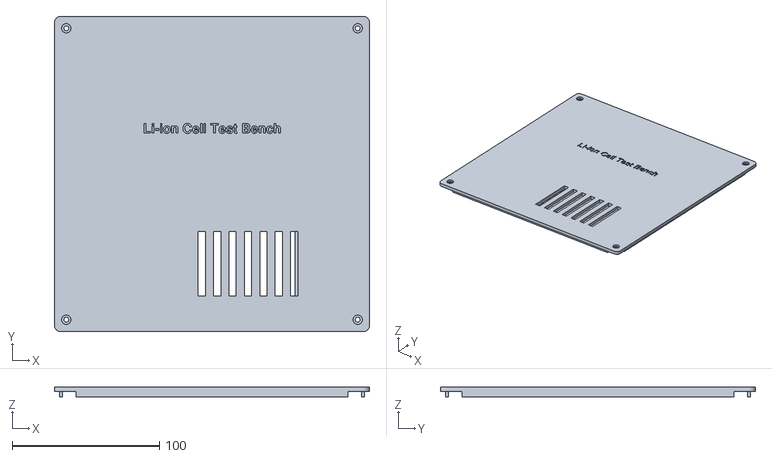
[picture p10: CAD file, 2026-11-10]
mechanical/stl/E2_ebox_lid.stl
214.0 x 214.0 x 7.00
