0hasant/Liion_Cell_Simulator/mechanical/stl/T2_pocket_body.stl

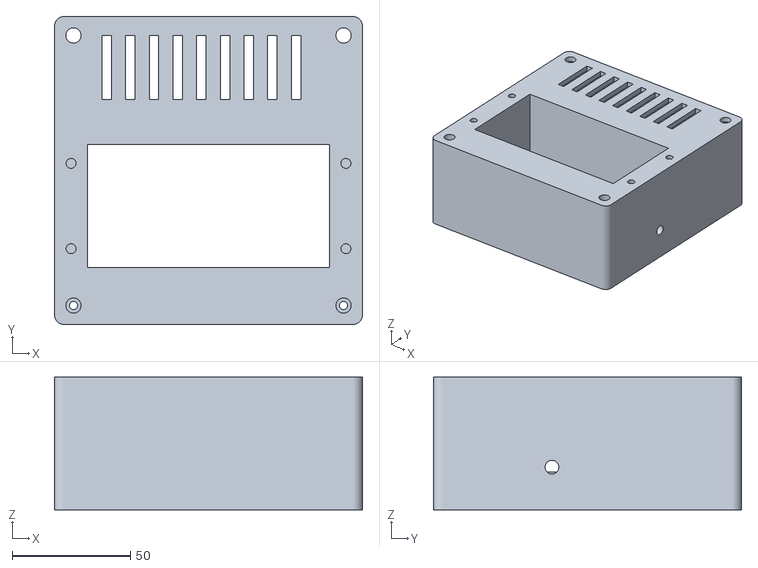
[picture p11: CAD file, 2026-11-10]
mechanical/stl/T2_pocket_body.stl
130.0 x 130.0 x 56.0
