0hasant/Liion_Cell_Simulator/mechanical/stl/E1_ebox_base.stl

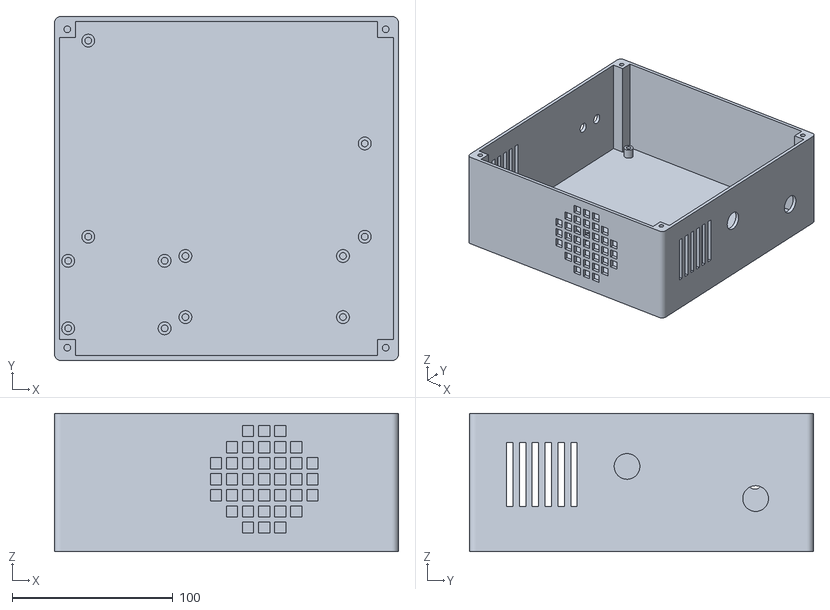
[picture p12: CAD file, 2026-11-10]
mechanical/stl/E1_ebox_base.stl
214.0 x 214.0 x 86.0
