0hasant/Liion_Cell_Simulator/mechanical/stl/E4_cooler_cradle.stl

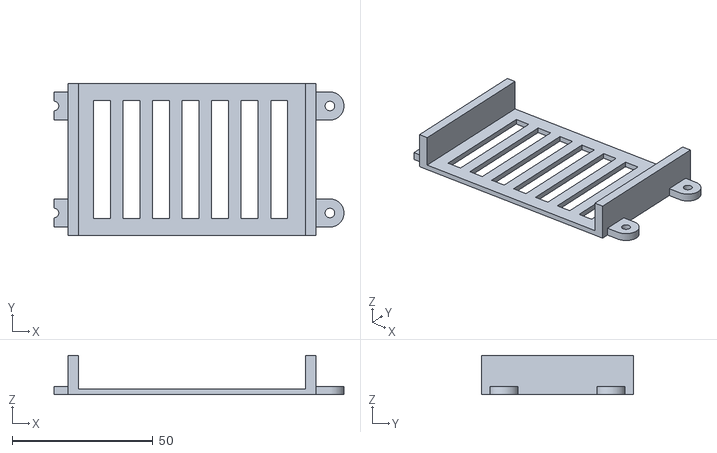
[picture p13: CAD file, 2026-11-10]
mechanical/stl/E4_cooler_cradle.stl
103.0 x 54.0 x 14.0
