0hasant/Liion_Cell_Simulator/mechanical/stl/T6_saddle_18650.stl

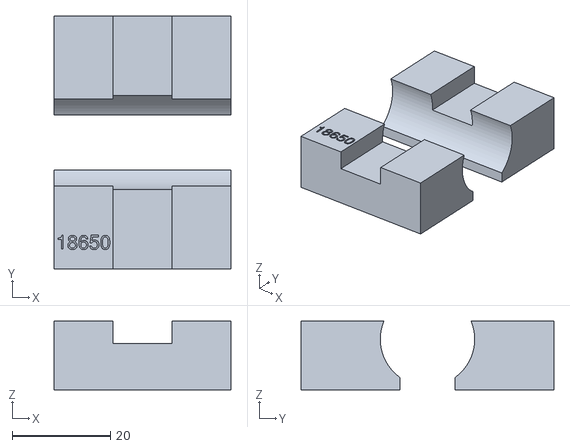
[picture p14: CAD file, 2026-10-27]
mechanical/stl/T6_saddle_18650.stl
36.0 x 51.4 x 13.9
