0hasant/Liion_Cell_Simulator/mechanical/stl/E3_module_plate.stl

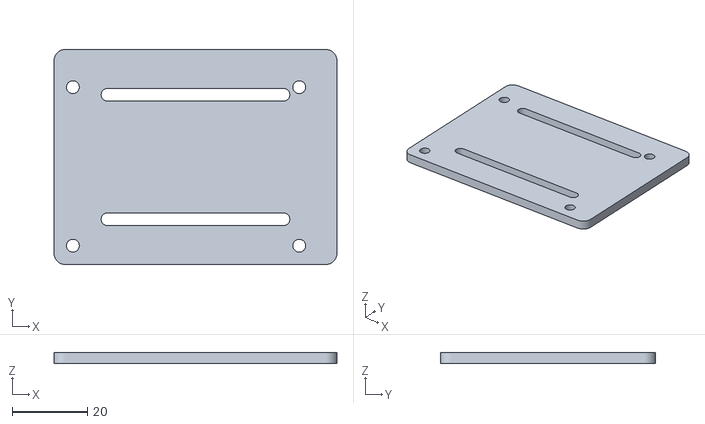
[picture p15: CAD file, 2026-10-27]
mechanical/stl/E3_module_plate.stl
75.0 x 57.0 x 3.00
