0hasant/Liion_Cell_Simulator/mechanical/stl/T5_contact_block_slider.stl

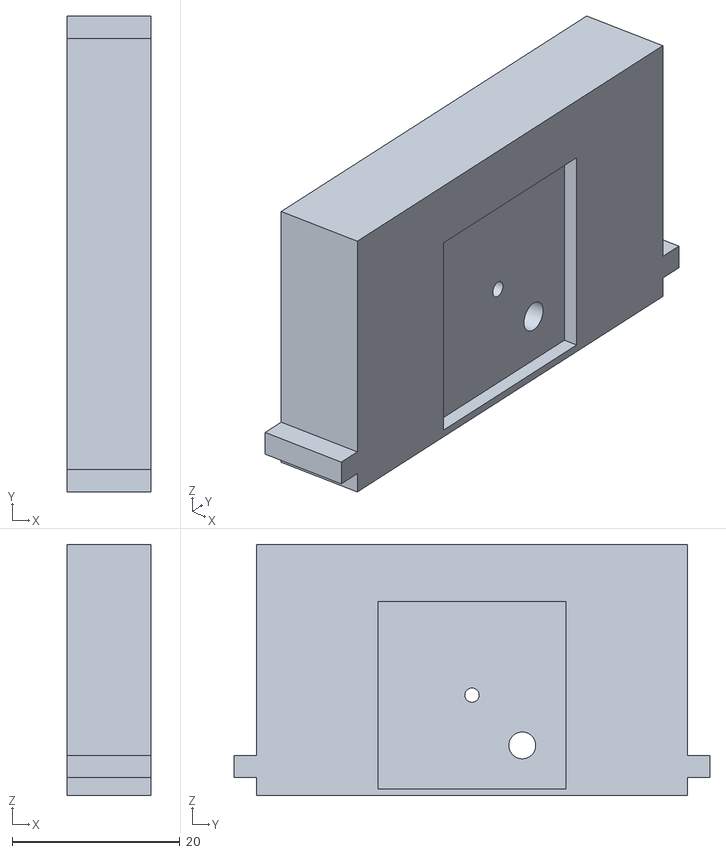
[picture p16: CAD file, 2026-10-27]
mechanical/stl/T5_contact_block_slider.stl
10.0 x 56.8 x 30.0
