0hasant/Liion_Cell_Simulator/mechanical/stl/T7_saddle_21700.stl

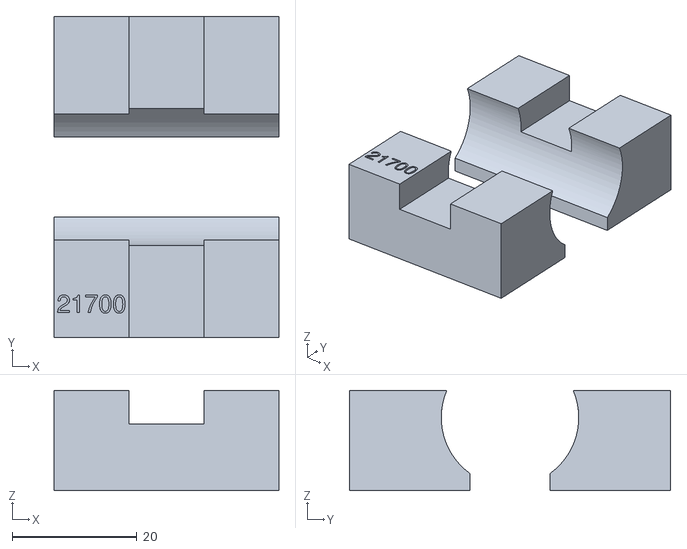
[picture p17: CAD file, 2026-10-27]
mechanical/stl/T7_saddle_21700.stl
36.0 x 51.4 x 16.0
