0hasant/Liion_Cell_Simulator/(list of files, cad)

Other CAD files:
mechanical/stl/T4_contact_block_fixed.stl
