0hasant/Liion_Cell_Simulator/mechanical/renders/assembly_exploded.png

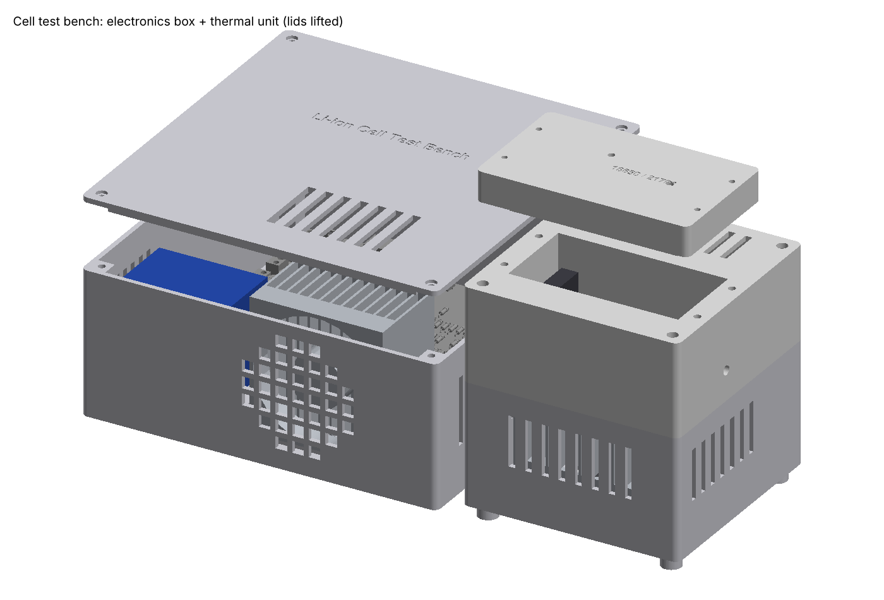
mechanical/renders/assembly_exploded.png
