0hasant/Liion_Cell_Simulator/hardware/fab/print/assembly_component_side_1to1.pdf

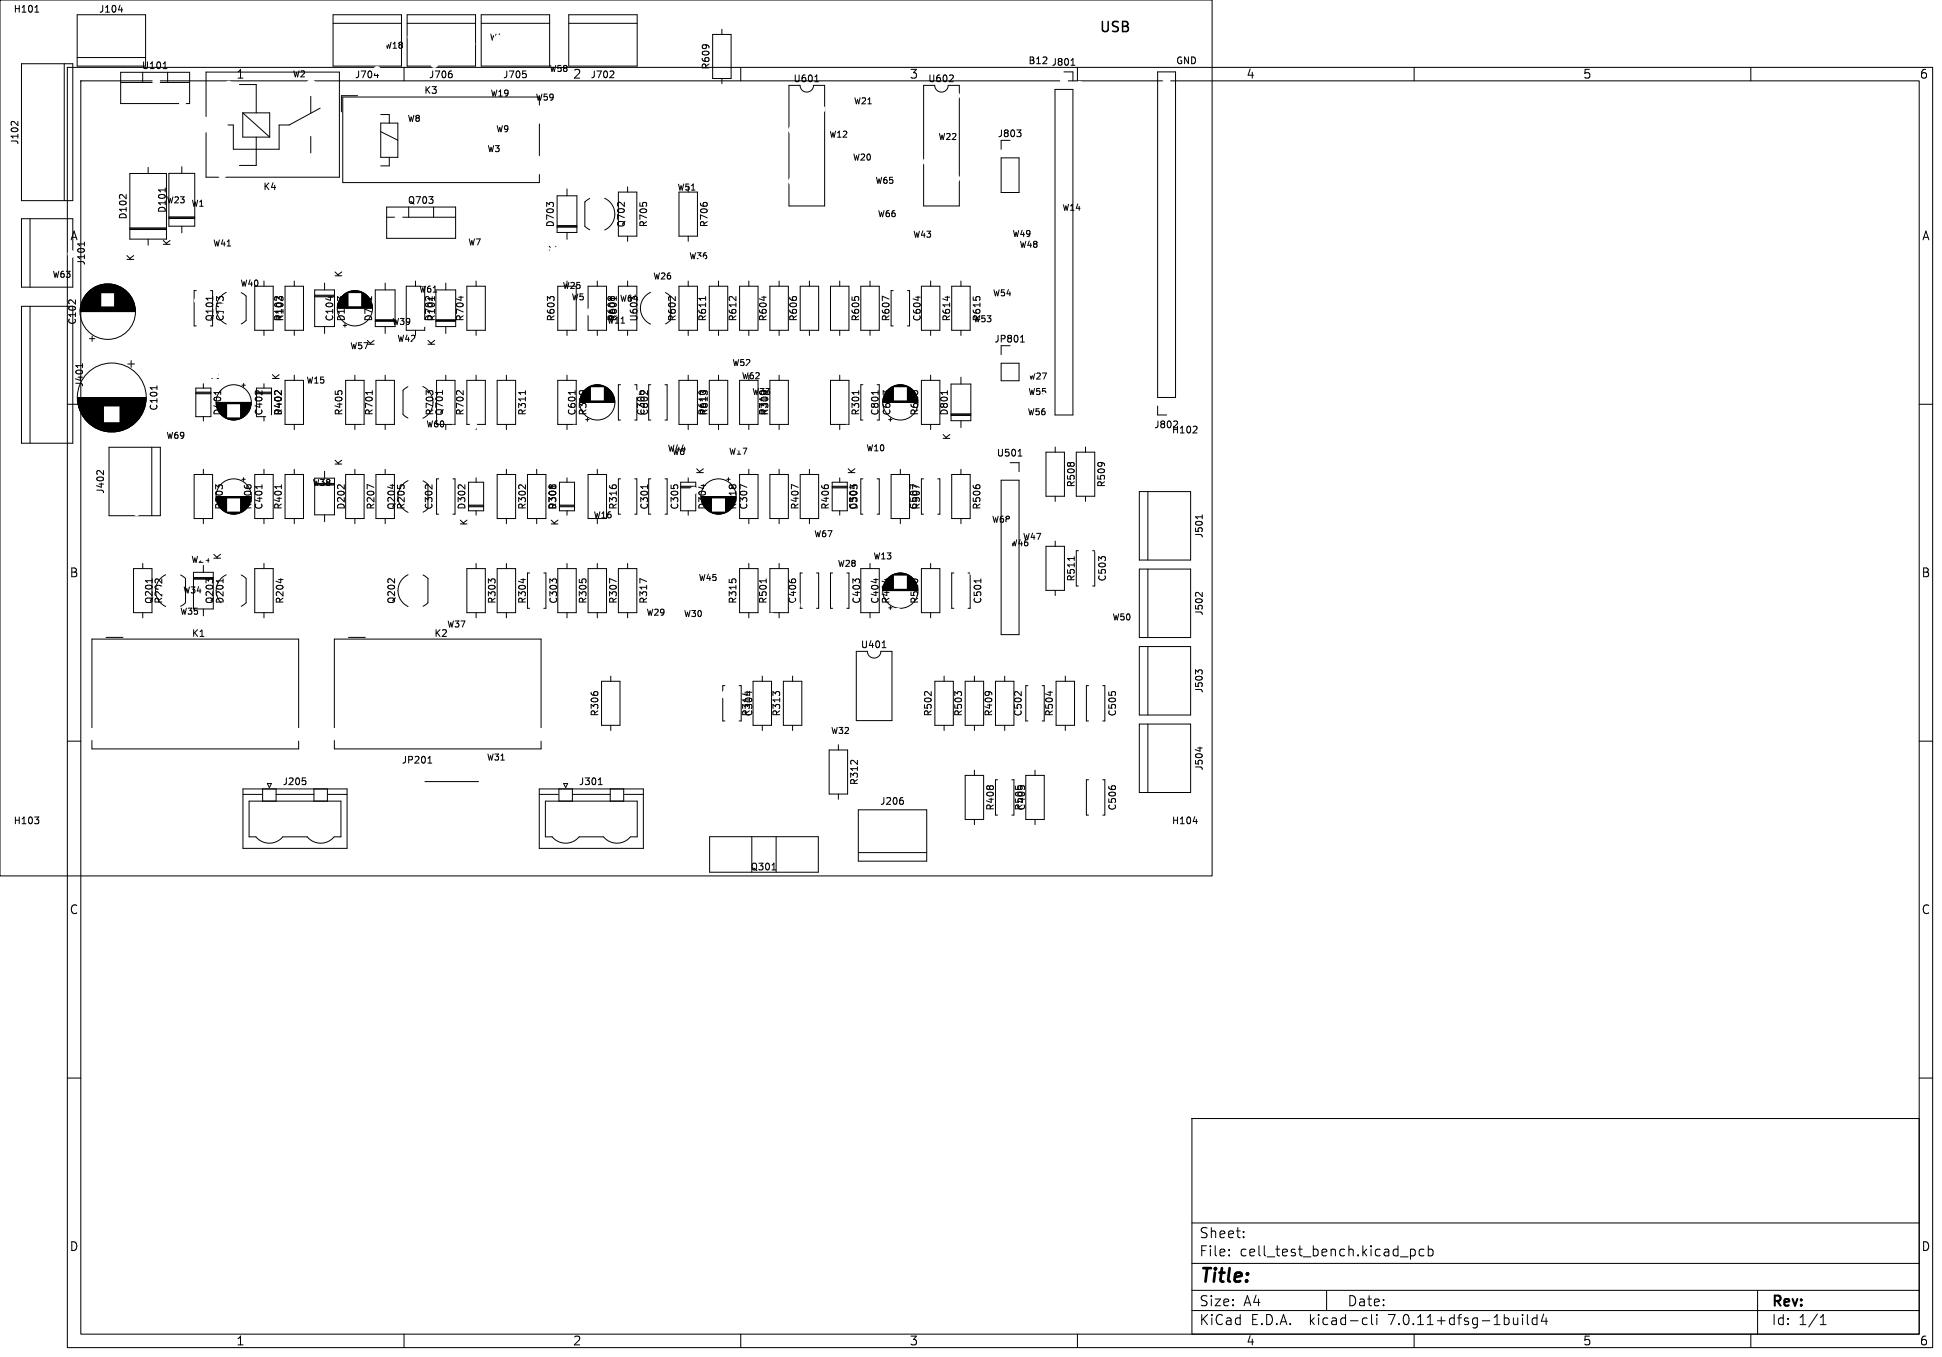
[picture p19: page 1]

Id: 1/1 Title: File: cell_test_bench.kicad_pcb Sheet:
