0hasant/Liion_Cell_Simulator/hardware/fab/print/copper_from_component_side_1to1.pdf

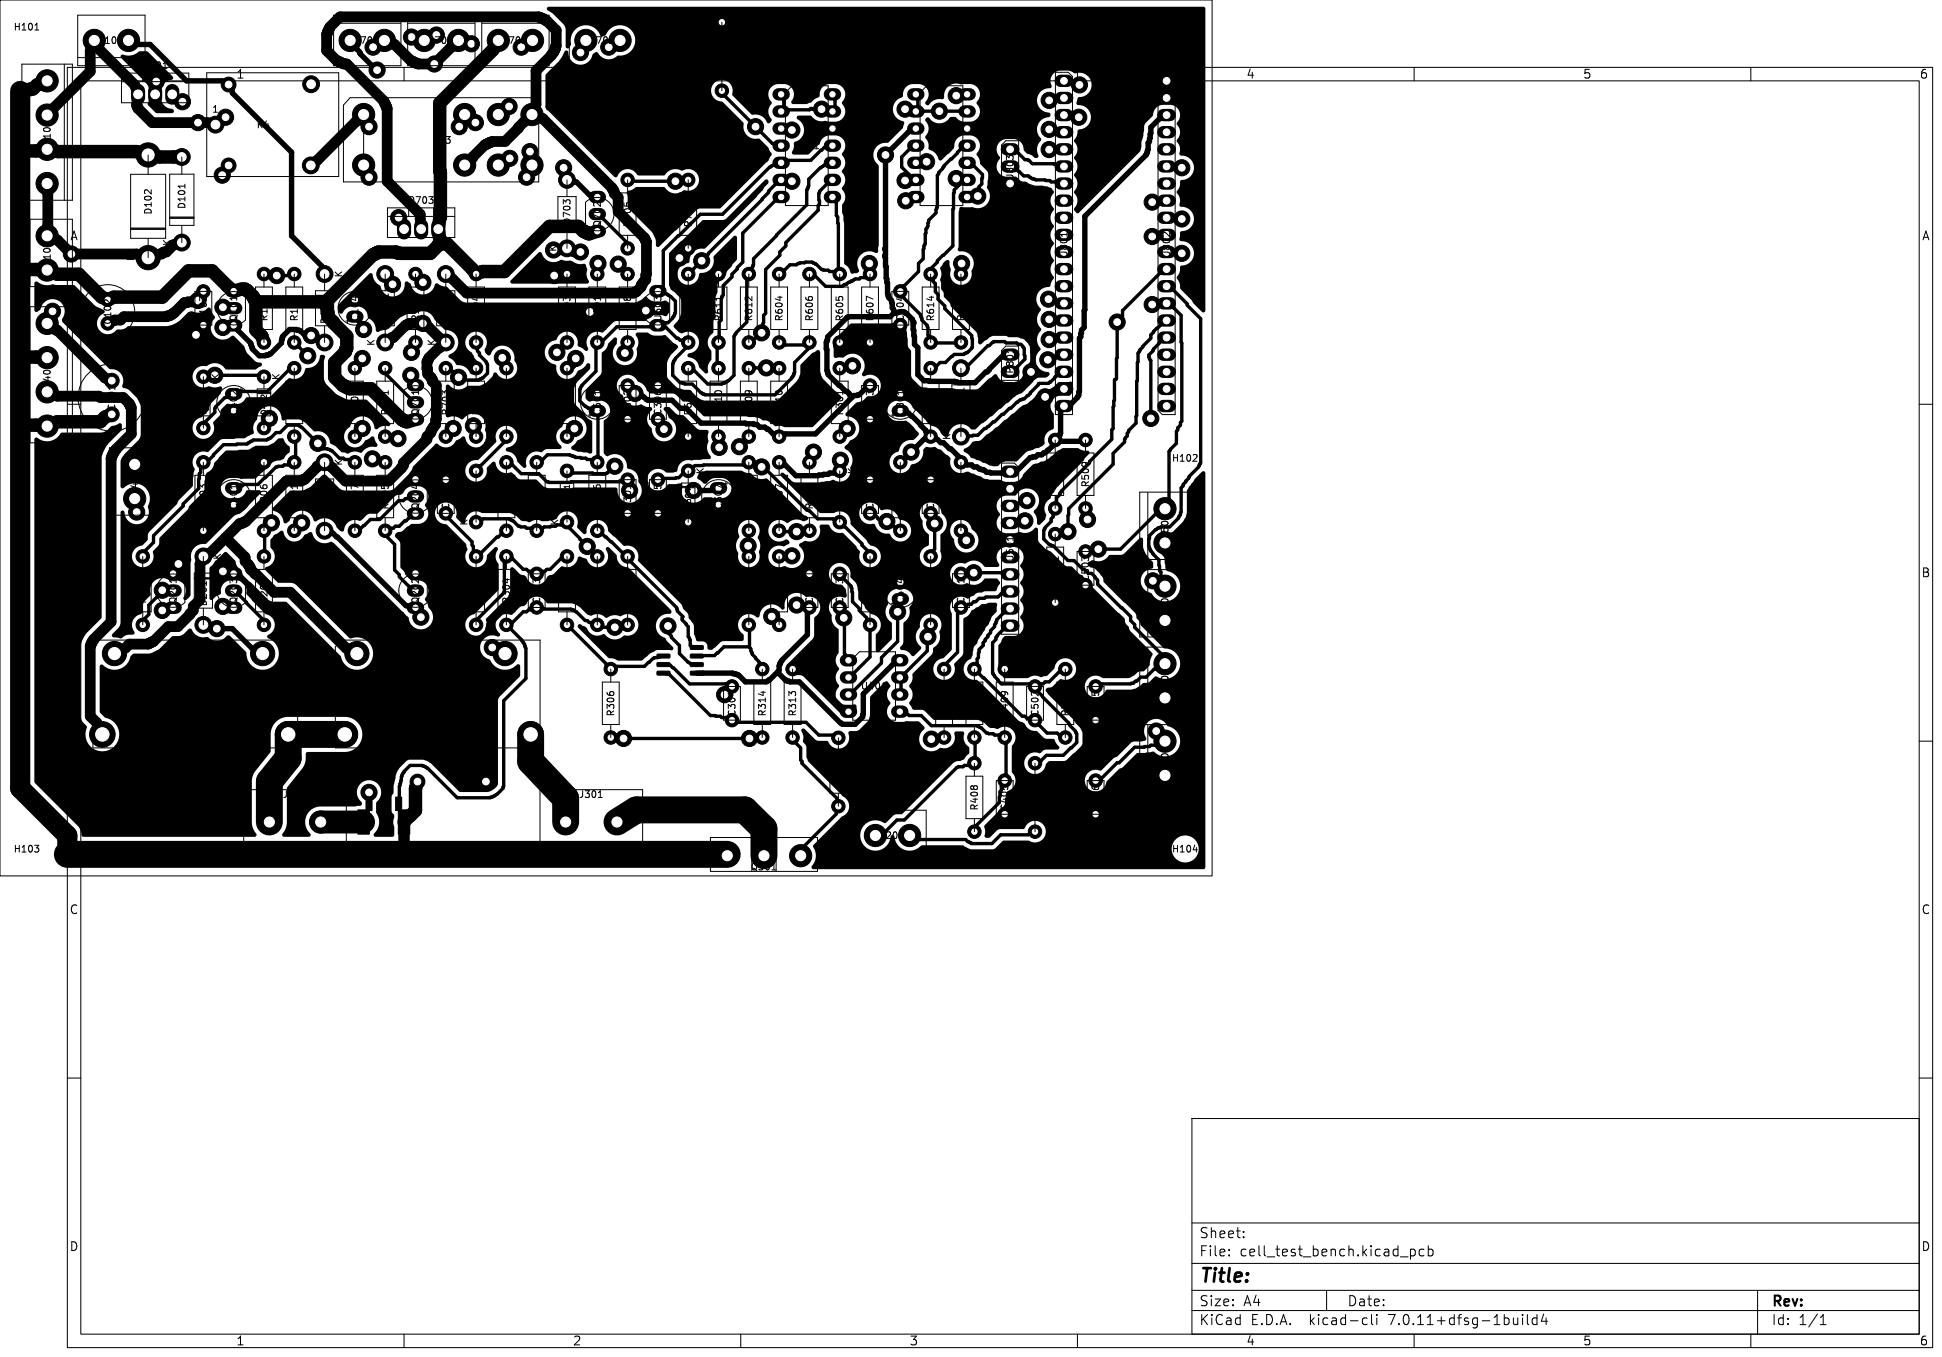
[picture p20: page 1]
