0hasant/Liion_Cell_Simulator/hardware/kicad/cell_test_bench.kicad_pcb

## KiCad design hardware/kicad/cell_test_bench.kicad_pcb (2026-11-10)

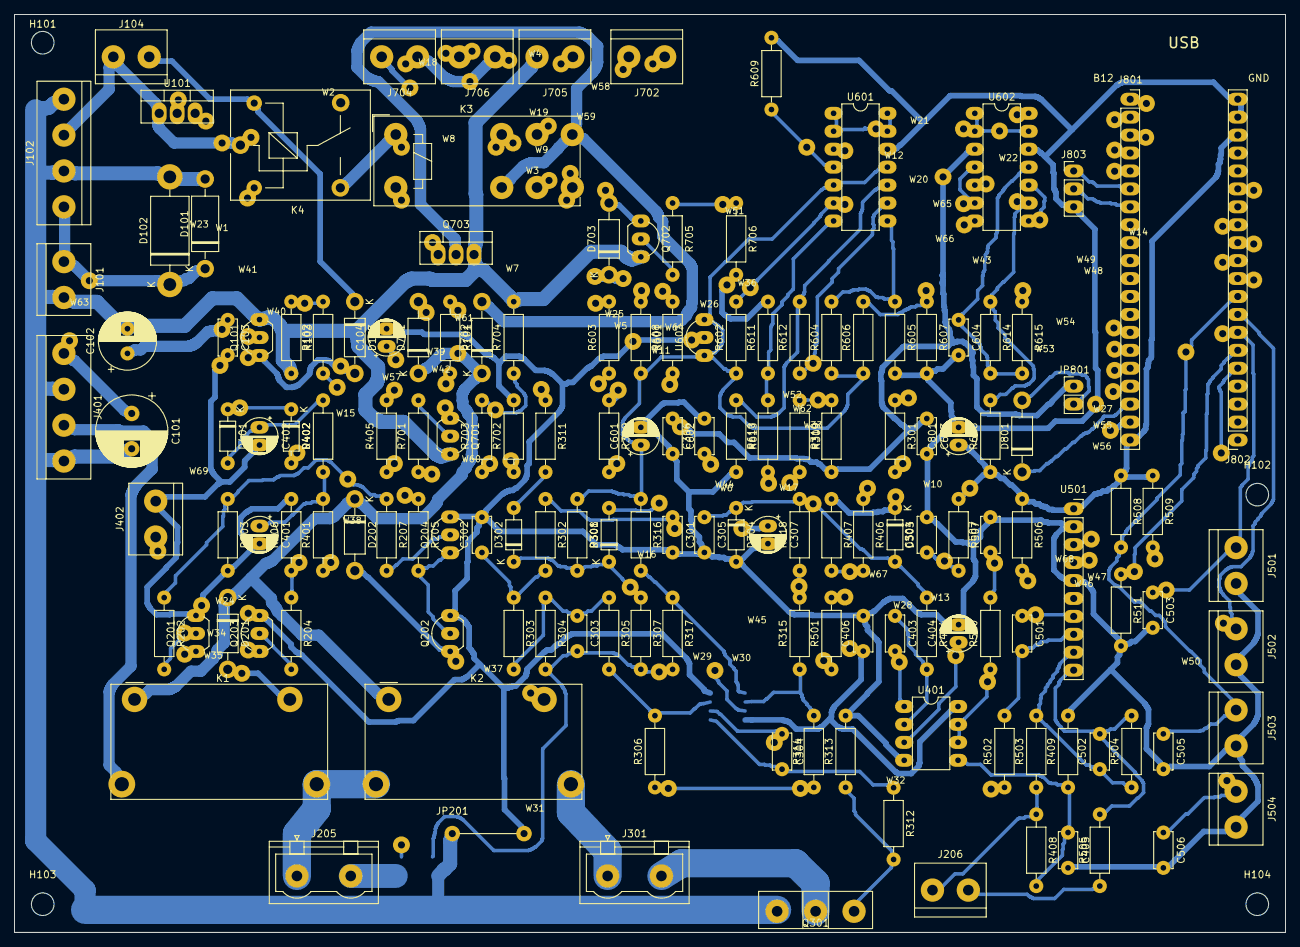
[picture p21: board cell_test_bench.kicad_pcb from above]

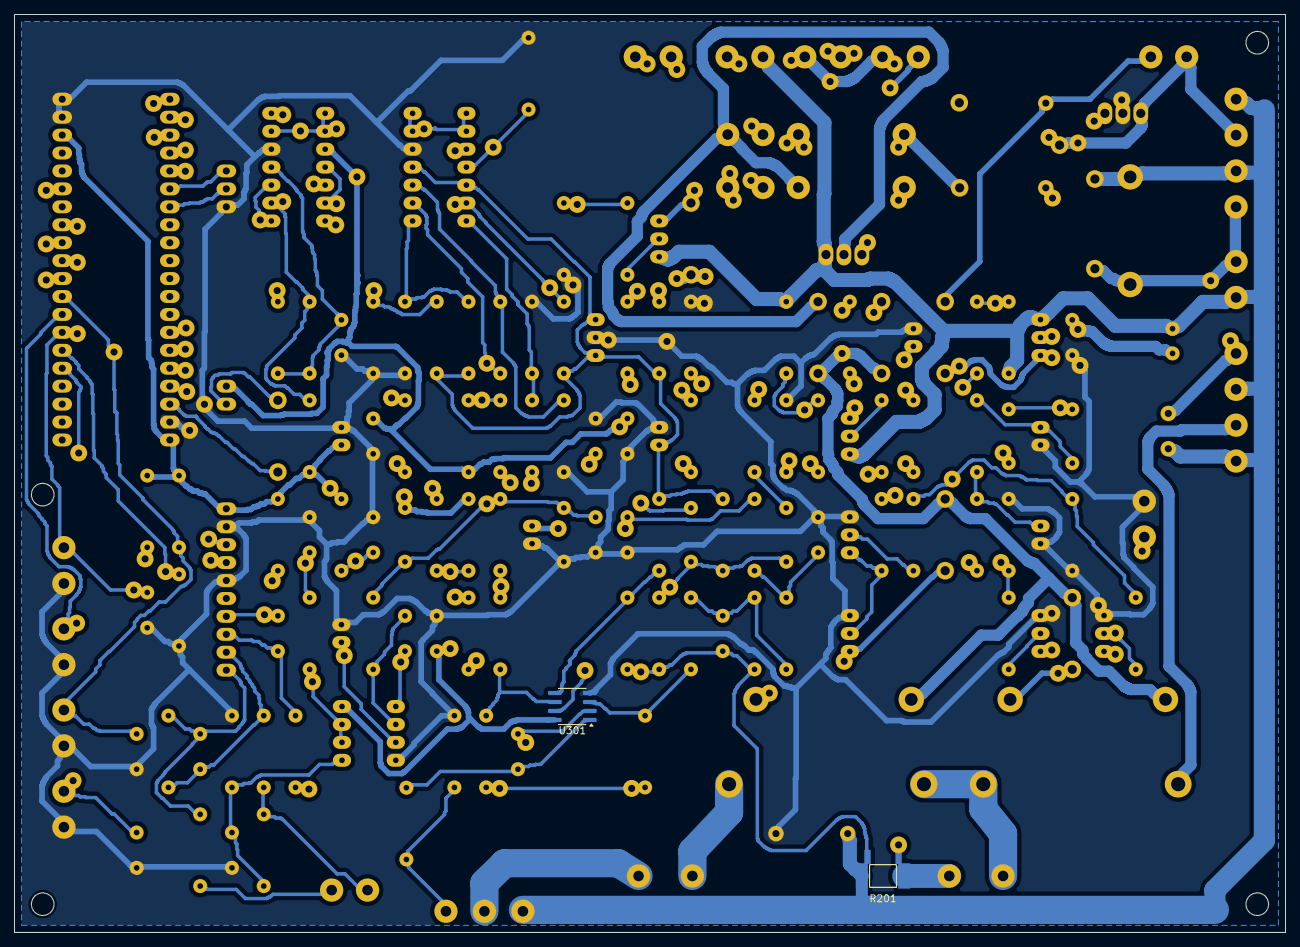
[picture p22: board cell_test_bench.kicad_pcb from below]

Board: 2 copper layers, 180.0 x 130.0 mm, 228 parts (2 on the bottom side), 91 nets.

Parts:
C101: 100uF 50V; CP_Radial_D10.0mm_P5.00mm
C102: 220uF 25V; CP_Radial_D8.0mm_P3.50mm
C103, C303, C306, C403, C406, C501, C502, C503, C504, C505, C506, C602, C603: 100nF; C_Disc_D5.0mm_W2.5mm_P5.00mm
C104, C307, C401, C402, C404, C601, C801: 10uF 25V; CP_Radial_D5.0mm_P2.50mm
C301, C302: 1uF; C_Disc_D5.0mm_W2.5mm_P5.00mm
C304: 1nF; C_Disc_D5.0mm_W2.5mm_P5.00mm
C305, C405, C507, C604: 10nF; C_Disc_D5.0mm_W2.5mm_P5.00mm
D101: P6KE39CA (TVS); D_DO-15_P12.70mm_Horizontal
D102: 1N5408; D_DO-201AD_P15.24mm_Horizontal
D103, D201, D202, D701, D702, D703, D801: 1N5819; D_DO-41_SOD81_P10.16mm_Horizontal
D301, D302: 1N4148; D_DO-35_SOD27_P7.62mm_Horizontal
D303, D304, D401, D402: BAT85; D_DO-35_SOD27_P7.62mm_Horizontal
H101, H102, H103, H104: M3 mounting hole; MountingHole_3.2mm_M3
J101: PSU in 30V (+, -) via inline 5A fuse; TerminalBlock_bornier-2_P5.08mm
J102: 12V buck XL4016: IN+ IN- OUT+ OUT-; TerminalBlock_bornier-4_P5.08mm
J104: Thermostat 60C NC (on load heatsink); TerminalBlock_bornier-2_P5.08mm
J205: Cell power to pocket (+, -) via inline 15A fuse; PhoenixContact_GMSTBVA_2,5_2-G-7,62_1x02_P7.62mm_Vertical
J206: Cell Kelvin sense (+, -); TerminalBlock_bornier-2_P5.08mm
J301: Series R 0.1R 50W alu (off-board); PhoenixContact_GMSTBVA_2,5_2-G-7,62_1x02_P7.62mm_Vertical
J401: XL4016 CC/CV module: IN+ IN- OUT+ OUT-; TerminalBlock_bornier-4_P5.08mm
J402: XL4016 FB tap (pin 1 to the FB pin; pin 2 spare G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; TerminalBlock_bornier-2_P5.08mm
J501: NTC 10k cell; TerminalBlock_bornier-2_P5.08mm
J502: NTC 10k air; TerminalBlock_bornier-2_P5.08mm
J503: NTC 10k hs; TerminalBlock_bornier-2_P5.08mm
J504: NTC 10k tec; TerminalBlock_bornier-2_P5.08mm
J702: Peltier 2x TEC1-12706 in series (A, B); TerminalBlock_bornier-2_P5.08mm
J704: Fan 12V load heatsink (+,-); TerminalBlock_bornier-2_P5.08mm
J705: Pocket mixing fan 12V (+,-); TerminalBlock_bornier-2_P5.08mm
J706: Fan 12V Peltier hot side (+,-); TerminalBlock_bornier-2_P5.08mm
J801: Blue Pill header A: B12 B13 B14 B15 A8 A9 A10 A11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; PinSocket_1x20_P2.54mm_Vertical
J802: Blue Pill header B: VB C13 C14 C15 A0 A1 A2 A3 A4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; PinSocket_1x20_P2.54mm_Vertical
J803: Debug UART: TX RX GND; PinHeader_1x03_P2.54mm_Vertical
JP201: GND-PGND link (wire); WireLink_P10.16mm
JP801: Board 5V to Blue Pill (normally open); PinHeader_1x02_P2.54mm_Vertical
K1: ALFG2PF121 (charge); Relay_SPST_Panasonic_ALFG_FormA_CircularHoles
K2: ALFG2PF121 (load); Relay_SPST_Panasonic_ALFG_FormA_CircularHoles
K3: HK14FD-DC12V-SHG (DPDT, polarity); Relay_DPDT_Finder_40.52
K4: SRD-12VDC-SL-C (safety); Relay_SPDT_SANYOU_SRD_Series_Form_C
Q101, Q201, Q202, Q701, Q702: BC337; TO-92_Inline_Wide
Q203, Q204: BC547; TO-92_Inline_Wide
Q301: IRFP260N; TO-247-3_Vertical
Q703: IRLZ44N; TO-220-3_Vertical
R101, R102: 2.2k; R_Axial_DIN0207_L6.3mm_D2.5mm_P10.16mm_Horizontal
R103: 4.7k; R_Axial_DIN0207_L6.3mm_D2.5mm_P10.16mm_Horizontal
R201: 10mR 1% 2.5W 2512; R_Shunt_2512_Kelvin
R202, R205, R304, R314, R317, R318, R601, R701: 1k; R_Axial_DIN0207_L6.3mm_D2.5mm_P10.16mm_Horizontal
R203, R204, R206, R207, R301, R302, R305, R306, R307, R310, R313, R406, R408, R503, R504, R506, R507, R508, R509, R510, R511, R602, R603, R605, R615, R616, R702, R704, R706: 10k; R_Axial_DIN0207_L6.3mm_D2.5mm_P10.16mm_Horizontal
R303: 6.8k; R_Axial_DIN0207_L6.3mm_D2.5mm_P10.16mm_Horizontal
R308: 10M; R_Axial_DIN0207_L6.3mm_D2.5mm_P10.16mm_Horizontal
R309, R613, R614: 100k; R_Axial_DIN0207_L6.3mm_D2.5mm_P10.16mm_Horizontal
R311: 150k; R_Axial_DIN0207_L6.3mm_D2.5mm_P10.16mm_Horizontal
R312, R319, R501, R502, R505, R703: 100R; R_Axial_DIN0207_L6.3mm_D2.5mm_P10.16mm_Horizontal
R315: 12k; R_Axial_DIN0207_L6.3mm_D2.5mm_P10.16mm_Horizontal
R316: 18k; R_Axial_DIN0207_L6.3mm_D2.5mm_P10.16mm_Horizontal
R401, R402: 560R; R_Axial_DIN0207_L6.3mm_D2.5mm_P10.16mm_Horizontal
R404, R609: 15k; R_Axial_DIN0207_L6.3mm_D2.5mm_P10.16mm_Horizontal
R405: 3.3k; R_Axial_DIN0207_L6.3mm_D2.5mm_P10.16mm_Horizontal
R407: 22k; R_Axial_DIN0207_L6.3mm_D2.5mm_P10.16mm_Horizontal
R409: 1M; R_Axial_DIN0207_L6.3mm_D2.5mm_P10.16mm_Horizontal
R604, R611: 16k; R_Axial_DIN0207_L6.3mm_D2.5mm_P10.16mm_Horizontal
R606: 27k; R_Axial_DIN0207_L6.3mm_D2.5mm_P10.16mm_Horizontal
R607, R610: 9.1k; R_Axial_DIN0207_L6.3mm_D2.5mm_P10.16mm_Horizontal
R608: 11k; R_Axial_DIN0207_L6.3mm_D2.5mm_P10.16mm_Horizontal
R612: 24k; R_Axial_DIN0207_L6.3mm_D2.5mm_P10.16mm_Horizontal
R705: 470R; R_Axial_DIN0207_L6.3mm_D2.5mm_P10.16mm_Horizontal
U101: L7805CV; TO-220-3_Vertical
U301: OPA2171AIDR; SOIC-8_3.9x4.9mm_P1.27mm
U401: LM358P; DIP-8_W7.62mm
U501: ADS1115 module (ADDR=GND): VDD GND SCL SDA ADDR A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; PinSocket_1x10_P2.54mm_Vertical
U601, U602: LM339N; DIP-14_W7.62mm
U603: TL431 (TO-92); TO-92_Inline_Wide
W1, W2, W3, W4, W5: wire +12V; WireJumper
W6: wire +12VA; WireJumper
W7, W8, W9: wire +12V_SW; WireJumper
W10: wire +3V3; WireJumper
W11, W12: wire +5V; WireJumper
W13: wire ADC_IG; WireJumper
W14: wire ARM; WireJumper
W15: wire CC_INJ; WireJumper
W16: wire CC_OUT; WireJumper
W17: wire DL1; WireJumper
W18, W19: wire FAN_N; WireJumper
W20: wire FAN_PWM; WireJumper
W21, W22: wire FAULT_N; WireJumper
W23, W24, W25, W26, W27: wire GND; WireJumper
W28: wire ILIM; WireJumper
W29: wire INN; WireJumper
W30: wire ISNS_G; WireJumper
W31, W32: wire ISNS_N; WireJumper
W33: wire I_MON; WireJumper
W34: wire K1_B; WireJumper
W35: wire K1_COIL; WireJumper
W36: wire K1_EN; WireJumper
W37: wire K2_COIL; WireJumper
W38: wire K2_EN; WireJumper
W39: wire K3_COIL; WireJumper
W40: wire K4_B; WireJumper
W41, W42: wire K4_COIL; WireJumper
W43: wire LOAD_OFF; WireJumper
W44: wire LOFF_K; WireJumper
W45: wire MON_RAW; WireJumper
W46: wire NTC_AIR; WireJumper
W47, W48: wire NTC_CELL; WireJumper
W49: wire NTC_HS; WireJumper
W50: wire NTC_TEC; WireJumper
W51: wire OV_DIV; WireJumper
W52: wire PWM_C; WireJumper
W53: wire PWM_I; WireJumper
W54: wire PWM_L; WireJumper
W55: wire SCL; WireJumper
W56: wire SDA; WireJumper
W57: wire SW_B; WireJumper
W58: wire TEC_A; WireJumper
W59: wire TEC_B; WireJumper
W60: wire TEC_DIR; WireJumper
W61: wire TEC_G; WireJumper
W62: wire TEC_PWM; WireJumper
W63: wire VIN; WireJumper
W64, W65: wire VREF_H; WireJumper
W66: wire VREF_T; WireJumper
W67: wire V_CELL; WireJumper
W68: wire V_FAST; WireJumper
W69: wire XL_FB; WireJumper

Connections:
+3V3: C801.1, D303.1, J801.20, J802.18, R407.1, R506.1, R507.1, R508.1, R509.1, R616.1, U501.1, W10.1, W10.2
+5V: C104.1, C602.1, C603.1, JP801.1, R101.1, R310.1, R601.1, U101.3, U601.3, U602.3, W11.1, W11.2, W11.3, W11.4, W11.5, W12.1, W12.2
+12V: C102.1, C103.1, D703.1, J102.3, J104.1, J704.1, J705.1, J706.1, K4.1, R319.1, U101.1, W1.1, W1.2, W2.1, W2.2, W3.1, W3.2, W4.1, W4.2, W5.1, W5.2
+12VA: C306.1, C307.1, C406.1, R319.2, U301.8, U401.8, W6.1, W6.2, W6.3, W6.4
+12V_SW: D201.1, D202.1, D701.1, D702.1, K1.A1, K2.A1, K3.12, K3.24, K3.A1, K4.3, W7.1, W7.2, W8.1, W8.2, W9.1, W9.2
/Cell_Relays/CELL_N: J205.2, R201.1
/Cell_Relays/CELL_P: J205.1, K1.14, K2.11
/Cell_Relays/K1_B: Q201.2, Q203.1, R202.2, W34.1, W34.2
/Cell_Relays/K1_COIL: D201.2, K1.A2, Q201.1, W35.1, W35.2
/Cell_Relays/K1_IB: Q203.2, R204.2
/Cell_Relays/K2_B: Q202.2, Q204.1, R205.2
/Cell_Relays/K2_COIL: D202.2, K2.A2, Q202.1, W37.1, W37.2
/Cell_Relays/K2_IB: Q204.2, R207.2
/Charger/CCN: C403.1, R404.2, U401.2
/Charger/CC_INJ: D402.2, R405.2, W15.1, W15.2
/Charger/CC_OUT: C403.2, R405.1, U401.1, W16.1, W16.2
/Charger/DAC_C: C402.1, D401.2, R402.2
/Charger/DC1: C401.1, R401.2, R402.1
/Charger/ILIM: C404.1, R406.2, R407.2, U401.3, W28.1, W28.2
/Charger/SBUF: C405.1, R408.2, R409.1, U401.5
/Charger/XL_FB: D401.1, D402.1, J402.1, W69.1, W69.2
/Electronic_Load/DAC_L: C302.1, R302.2, R303.1
/Electronic_Load/DL1: C301.1, R301.2, R302.1, W17.1, W17.2
/Electronic_Load/FLT_K: D302.2, R311.2
/Electronic_Load/GATE: Q301.1, R312.2, R313.1
/Electronic_Load/INN: C304.1, D301.1, D302.1, R307.1, R308.2, U301.2, W29.1, W29.2
/Electronic_Load/INP: R305.2, R306.2, U301.3
/Electronic_Load/LOAD_D: J301.2, Q301.2
/Electronic_Load/LOFF_K: D301.2, R309.2, W44.1, W44.2
/Electronic_Load/MB: R316.2, R317.1, U301.5
/Electronic_Load/MN: R314.2, R315.1, U301.6
/Electronic_Load/MON_RAW: R315.2, R318.1, U301.7, W45.1, W45.2
/Electronic_Load/OA_OUT: C304.2, R312.1, U301.1
/Electronic_Load/SETP: C303.1, R303.2, R304.1, R305.1
/MCU/BP_5V: D801.1, J801.18
/MCU/BP_J: D801.2, JP801.2
/MCU/DBG_RX: J801.7, J803.2
/MCU/DBG_TX: J801.6, J803.1
/Measurement/ADC_IG: C501.1, R501.2, U501.7, W13.1, W13.2
/Measurement/ADC_IN: C501.2, R502.2, U501.8
/Measurement/ADC_VN: C502.2, R504.2, R505.2, U501.10
/Measurement/ADC_VP: C502.1, R503.2, R504.1, U501.9
/Power/K4_B: Q101.2, R102.2, R103.1, W40.1, W40.2
/Power/TSTAT: D103.1, J104.2, K4.5
/Protection/ID_DIV: R612.2, R613.1, U601.10
/Protection/LATCH_IN: C604.1, R614.2, R615.2, U602.11
/Protection/OV_DIV: R608.2, R609.1, U601.4, W51.1, W51.2
/Protection/UV_DIV: R610.2, R611.1, U601.7
/Protection/VREF_C: R604.2, R605.1, U601.8
/Protection/VREF_H: R602.2, R603.1, U601.6, U602.8, U602.10, W64.1, W64.2, W65.1, W65.2
/Protection/VREF_T: R606.2, R607.1, U602.4, U602.6, W66.1, W66.2
/Thermal/FAN_B: Q702.2, R705.2
/Thermal/FAN_N: D703.2, J704.2, J706.2, Q702.1, W18.1, W18.2, W19.1, W19.2
/Thermal/K3_B: Q701.2, R701.2
/Thermal/K3_COIL: D701.2, K3.A2, Q701.1, W39.1, W39.2, W39.3
/Thermal/TEC_A: J702.1, K3.11, W58.1, W58.2
/Thermal/TEC_B: J702.2, K3.21, W59.1, W59.2
/Thermal/TEC_G: Q703.1, R703.2, R704.1, W61.1, W61.2
/Thermal/TEC_SW: D702.2, K3.14, K3.22, Q703.2
ARM: J802.15, R615.1, W14.1, W14.2
CHG_OUT: J401.3, K1.11
FAN_PWM: J801.5, R705.1, R706.1, W20.1, W20.2
FAULT_N: J801.4, R614.1, R616.2, U601.1, U601.2, U601.13, U601.14, U602.1, U602.2, U602.9, U602.13, W21.1, W21.2, W22.1, W22.2, W22.3
GND: C103.2, C104.2, C301.2, C302.2, C305.2, C306.2, C307.2, C401.2, C402.2, C404.2, C405.2, C406.2, C503.2, C504.2, C505.2, C506.2, C507.2, C601.2, C602.2, C603.2, C604.2, C801.2, D304.2, J402.2, J501.2, J502.2, J503.2, J504.2, J801.19, J802.19, J802.20, J803.3, JP201.2, Q201.3, Q202.3, Q203.3, Q204.3, R203.2, R206.2, R313.2, R409.2, R511.2, R603.2, R605.2, R607.2, R609.2, R611.2, R613.2, R702.2, R706.2, U101.2, U301.4, U401.4, U501.2, U501.5, U601.12, U602.12, U603.2, W23.1, W23.2, W24.1, W24.2, W25.1, W25.2, W26.1, W26.2, W27.1, W27.2
ISNS_G: C303.2, R201.3, R304.2, R307.2, R317.2, R501.1, W30.1, W30.2
ISNS_N: R201.2, R306.1, R314.1, R502.1, W31.1, W31.2, W32.1, W32.2
I_MON: C305.1, D303.2, D304.1, J802.5, R318.2, R404.1, R612.1, U601.9, W33.1, W33.2, W33.3
K1_EN: J801.1, R202.1, R203.1, R207.1, W36.1, W36.2
K2_EN: J801.2, R204.1, R205.1, R206.1, W38.1, W38.2, W38.3
K4_COIL: D103.2, K4.2, Q101.1, R311.1, W41.1, W41.2, W42.1, W42.2
LOAD_OFF: J801.3, R309.1, R310.2, W43.1, W43.2
LOAD_P: J301.1, K2.14
NTC_AIR: C504.1, J502.1, J802.8, R507.2, W46.1, W46.2
NTC_CELL: C503.1, J501.1, J802.7, R506.2, U602.7, W47.1, W47.2, W48.1, W48.2
NTC_HS: C505.1, J503.1, J802.9, R508.2, U602.5, W49.1, W49.2
NTC_TEC: C506.1, J504.1, J802.10, R509.2, W50.1, W50.2, W50.3
PGND: C101.2, C102.2, D101.2, D102.2, J101.2, J102.2, J102.4, J401.2, J401.4, J705.2, JP201.1, Q101.3, Q301.3, Q701.3, Q702.3, Q703.3, R103.2, R201.4, R704.2
PWM_C: J802.12, R401.1, W52.1, W52.2
PWM_I: J802.13, R406.1, W53.1, W53.2
PWM_L: J802.11, R301.1, W54.1, W54.2
SCL: J801.14, U501.3, W55.1, W55.2
SDA: J801.15, U501.4, W56.1, W56.2
SENSE_N: J206.2, R505.1
SENSE_P: J206.1, R408.1, R503.1
SW_B: R101.2, R102.1, U602.14, W57.1, W57.2, W57.3
TEC_DIR: J801.17, R701.1, R702.1, W60.1, W60.2, W60.3
TEC_PWM: J801.16, R703.1, W62.1, W62.2
VIN: C101.1, D101.1, D102.1, J101.1, J102.1, J401.1, W63.1, W63.2
VREF: C601.1, R308.1, R316.1, R601.2, R602.1, R604.1, R606.1, U601.5, U601.11, U603.1, U603.3
V_CELL: R510.1, R608.1, R610.1, U401.6, U401.7, W67.1, W67.2, W67.3
V_FAST: C507.1, J802.6, R510.2, R511.1, W68.1, W68.2
