0hasant/Liion_Cell_Simulator/(commit log)

2026-10-13 Add schematic draft v0.1 for the cell test bench
    KiCad project with 8 hierarchical sheets (power, cell/relays, load,
    charger, measurement, protection, thermal, MCU), generator script,
    draft BOM and PDF export.
    Claude-Session: https://claude.ai/code/session_014GYMr1Hijv8YiJ3hqYzU64
    [bom_draft.csv, cell_test_bench.kicad_sch, charger.kicad_sch, load.kicad_sch, mcu.kicad_sch, measurement.kicad_sch, power.kicad_sch, protection.kicad_sch]
2026-10-13 Updated for kicad 10
    [cell_test_bench.kicad_sch, charger.kicad_sch, load.kicad_sch, mcu.kicad_sch, measurement.kicad_sch, power.kicad_sch, protection.kicad_sch, relays.kicad_sch]
2026-10-27 Schematic v0.2: hand-solder parts and footprints
    - Swap SOT-23 parts for THT (BS170, IRLZ44N, TL431 TO-92, BAT85, 1N5819)
    - Relays K1/K2 are now Panasonic ALFG2PF121 PCB relays (Ozdisan stock)
    - Shunt is Ohmite LVK25 10 mOhm 2 W 4-terminal
    - Assign footprints to every part from a project library in
    hardware/kicad/lib (footprints + STEP models)
    - BOM with Ozdisan links where available
    Saved in KiCad 7 format; KiCad 10 upgrades it on save.
    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
    [bom.csv, bom_draft.csv, cell_test_bench.kicad_sch, charger.kicad_sch, load.kicad_sch, mcu.kicad_sch, measurement.kicad_sch, power.kicad_sch]
2026-10-27 PCB v0.2: board outline, placement, net classes, GND pours
    180 x 130 mm, 2 layers. Terminal blocks on the edges with wire entry
    outward, IRFP260N at the bottom edge with its back facing out for the
    heatsink, Blue Pill USB at the top edge. Module overhang areas are
    keep-out rule areas. Net classes: HighCurrent 3 mm, Supply 1 mm,
    Sense 0.3 mm. Not routed yet.
    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
    [cell_test_bench.kicad_pcb]
2026-10-27 Mechanical: electronics box and thermal cell pocket (CadQuery)
    - Electronics box 214x214 mm: PCB standoffs, load heatsink + 60 mm fan,
    XL4016 stack, binding posts, USB opening, harness grommets, vented lid
    - Thermal unit 130x130 mm: hot-side heatsink + fan, 2x TEC1-12706,
    aluminium cold plate, insulated pocket with swappable 18650/21700
    saddles, sliding Kelvin contact blocks, BTS7960 under a vented cover
    - STL parts (all fit a 220x220 bed), full STEP assembly with the KiCad
    board, PNG renders, print/hardware notes
    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
    [E1_ebox_base.stl, E2_ebox_lid.stl, E3_module_plate.stl, E4_heatsink_clamp.stl, T1_thermal_base.stl, T2_pocket_body.stl, T3_pocket_lid.stl, T4_contact_block_fixed.stl]
2026-10-28 PCB v0.2 routed: DRC clean, 0 unconnected
    - Placement regrouped: passives next to their modules, more room around
    the load op-amp
    - Routed with hardware/tools/router.py (grid router on scikit-image MCP):
    3 mm high-current tracks, 1 mm supplies, 0.3 mm signals, net-class
    aware clearances, B.Cu kept mostly clear for the GND pour, SMD GND
    pads fanned out to vias, stitching vias
    - Repair/rip-up helpers for the last few connections
    - KiCad DRC: 0 errors, 0 unconnected (only 'library not in global table'
    warnings from the standalone check; the project fp-lib-table covers it)
    - docs: top/bottom renders, DRC report, schematic PDF
    - Board STEP and enclosure assembly regenerated with the rou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
    [cell_test_bench.kicad_pcb, cell_test_bench.step, cell_test_bench_assembly.step]
2026-10-28 Add docs/PROJECT_SYNC.md (master copy) with review fixes; ignore KiCad .history
    - Sync file is now committed in the repo as the master copy
    - Section 7: BTS7960 location mismatch between PCB and mechanics
    - Per-cell charge limit, thermostat mount, NTC locations, mounting-hole
    coordinates, cable list, SOIC-8/LVK25 in the hand-solder rule
    - Budget marked as not verified (BOM has no prices)
    - .gitignore: KiCad 10 local history folder (.history/)
    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
2026-10-28 Quilter test
    [cell_test_bench.kicad_pcb, cell_test_bench.kicad_sch, charger.kicad_sch, load.kicad_sch, mcu.kicad_sch, measurement.kicad_sch, power.kicad_sch, protection.kicad_sch]
2026-10-28 Notes added
    [cell_test_bench.kicad_pcb, thermal.kicad_sch]
2026-10-28 v0.3.1: BTS7960 decision + Quilter v0.3 job results
    - PROJECT_SYNC: BTS7960 location decided (option a), Peltiers wired
    directly to the driver in the thermal unit; changelog entry.
    - QUILTER_NOTES: results of job "v0.3 CNC 2-layer" (6 candidates,
    89.9-93.7 % routed, 104-161 vias), relay coil slot problem (2.1 x 0.5 mm,
    not drillable on CNC), changes planned for the next job.
    - LAYOUT_REVIEW: results table filled; candidate 1.1 kept for hand
    finishing, 6.1 runner-up.
    Claude-Session: https://claude.ai/code/session_01N3TcGPrSfbpVGMZk4Yw5cS
2026-10-28 v0.3.2: schematic guide, review checklist and sheet notes
    Layout work is paused so Hasan can review the schematic himself.
    - docs/SCHEMATIC_GUIDE.md (+ .pdf): block-by-block explanation of all
    8 sheets with redrawn circuit diagrams (docs/schematic_guide/*.svg),
    computed operating points, the public reference to cross-check each
    block against, firmware sequences and a summary of issues found.
    - docs/SCHEMATIC_REVIEW.md: checklist with Status / Your comment columns:
    57 circuit checks (P/R/L/C/M/X/T/U/F IDs) and every part with its
    pin-to-net connections, generated from the netlist.
    - Schematic sheets (hardware/kicad and hardware/quilter_input): added a
    "v0.3 REVIEW NOTES" block to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
    [charger.kicad_sch, load.kicad_sch, mcu.kicad_sch, measurement.kicad_sch, power.kicad_sch, protection.kicad_sch, relays.kicad_sch, thermal.kicad_sch]
2026-11-10 v0.4: hardware design complete (single-sided CNC board, Turkish BOM, enclosure)
    Schematic v0.4 (hardware/tools/design.py, docs/CHANGES_v0.4.md)
    - Parts replaced by ones in stock in Turkiye: MCP4725 x2 -> filtered PWM,
    second ADS1115 -> Blue Pill ADC for NTCs, BTS7960 -> DPDT polarity relay +
    IRLZ44N, OPA2188 -> OPA2171, LVK25 -> Isabellenhuette 2512 shunt with Kelvin
    taps, MP1584 -> 7805, BS170 -> BC337/BC547, 1206 -> through-hole, JST-XH ->
    screw terminals, P6KE33A -> P6KE39CA + 1N5408.
    - Review items closed: hardware charge-current limit (C-01), latched fault with
    safety relay K4 cutting +12V_SW (X-03, X-07), PGND/GND split joined at JP201
    (F-02), USB back-feed jumper (U-01), b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
    [E1_ebox_base.stl, E2_ebox_lid.stl, E4_cooler_cradle.stl, E4_heatsink_clamp.stl, T1_thermal_base.stl, T2_pocket_body.stl, T3_pocket_lid.stl, bom.csv]
